elegooofficial/neptune3plus/BOM/Neptune 3 Plus  Bom.xlsx

Neptune 3 Plus Bom
Order | Part Code | Part Name | Specification | UNIT | Qty
1 | 01.003.0011 | 4040 Aluminum profile_Bottom & Right | 40*40-L=486mm,Anodizing | pcs | 1
2 | 01.003.0012 | 4040 Aluminum profile_Bottom & Left | 40*40-L=486mm,Anodizing | pcs | 1
3 | 01.001.0015 | 2020 Aluminum profile_Bottom | 20*20-L=360mm,Anodizing | pcs | 2
4 | 01.002.0008 | 2040 Aluminum profile_Z-axis_Right | 20*40-L=558mm Anodizing+silk | pcs | 1
5 | 01.002.0009 | 2040 Aluminum profile_Z-axis_Left | 20*40-L=558mm Anodizing+silk | pcs | 1
6 | 01.001.0013 | 2020 Aluminum profile_X-axis | 20*20-L=461mm,Anodizing | pcs | 1
7 | 01.001.0014 | 2020 Aluminum profile_Top | 20*20-L=440mm,Anodizing | pcs | 1
8 | 01.002.0010 | 2040 Aluminum profile_Y-axis | 20*40-L=496mm,Anodizing | pcs | 2
9 | 01.006.0001 | φ18 Aluminum profile_Pull rod | φ18*L=548mm,Anodizing | pcs | 2
10 | 02.002.0046 | Cover Plate_Bottom | SPCC T=0.8mm，Spraying,Black | pcs | 1
11 | 02.002.0047 | Cover Plate_Top | SPCC T=1.0mm，Spraying,Black | pcs | 1
12 | 02.002.0048 | Cover Plate_Y-axis | SPCC T=1.0mm，Spraying,Black | pcs | 1
13 | 02.001.0017 | Fixing Plate_Top Bearing_Right | AL5052 T=3.0mm，Spraying,Black | pcs | 1
14 | 02.001.0018 | Fixing Plate_Top Bearing_Left | AL5052 T=3.0mm，Spraying,Black | pcs | 1
15 | 02.002.0049 | Fixing Plate_Y-Belt | SPCC T=1.5mm，Spraying,Black | pcs | 1
16 | 02.001.0019 | Bottom Slider Plate | AL5052 T=4.0mm，Spraying,Black | pcs | 1
17 | 02.002.0030 | Attraction Plate_Magnet | SECC T=1.5mm | pcs | 1
18 | 02.002.0035 | Fixing Plate_Z nut-Left | SPCC T=2.5mm，Spraying,Black | pcs | 1
19 | 02.002.0036 | Fixing Plate_X-axis-stepper | SPCC T=2.5mm，Spraying,Black | pcs | 1
20 | 02.002.0037 | Fixing Plate_Z nut-Right | SPCC T=2.5mm，Spraying,Black | pcs | 1
21 | 02.002.0038 | Driven Plate_Z-axis | SPCC T=2.5mm，Spraying,Black | pcs | 1
22 | 02.002.0039 | Fixing Plate_Extruder | SPCC T=2.5mm，Spraying,Black | pcs | 1
23 | 02.002.0040 | Fixing Plate_Extruder Fan | SPCC T=1.0mm，Spraying,Black | pcs | 1
24 | 02.002.0042 | Fixing Plate_Filament Detector | SPCC T=0.8mm，Spraying,Black | pcs | 1
25 | 02.002.0043 | Fixing Plate_Magnet | SPCC T=0.8mm，Spraying,Black | pcs | 1
26 | 02.002.0044 | Fixing Plate_Extruder Cable | SPCC T=1.0mm，Spraying,Black | pcs | 1
27 | 04.001.0019 | Ground Wire_Power Supply | 18AWG_L350mm_SV1.25-4 terminal+4.8 Plug spring terminal | pcs | 1
28 | 04.001.0020 | Black Silicone Wire | 16AWG Silicone Wire_L340mm_SV1.25-4 terminal+4.8 Plug spring terminal,Black | pcs | 1
29 | 04.001.0021 | Red Silicone Wire | 16AWG Silicone Wire_L340mm_SV1.25-4 terminal+4.8 Plug spring terminal,Red | pcs | 1
30 | 04.014.0003 | Extruder Cable | 26AWG_20Pin,L=2000mm | pcs | 1
31 | 04.003.0006 | Mainboard Wire | 2*1.5²_2Pin_L480mm_SV1.25-4 terminal+E1508 terminal,Red&Black | pcs | 1
32 | 04.005.0019 | Stepper and limit switch wire_Y-axis | 24AWG_6Pin,L1=570mm,L2=610mm,Black | pcs | 1
33 | 04.005.0020 | Stepper wire_Z-axis | 24AWG_2*4Pin,L1=770mm,L2=420mm,Black | pcs | 1
34 | 04.005.0021 | Stepper and limit switch wire_X-axis | 24AWG_6Pin,L1=1400mm,L2=1450mm,Black | pcs | 1
35 | 04.011.0014 | Filament Detector Wire | 26AWG_3Pin,L=820mm,Black | pcs | 1
36 | 04.012.0003 | LED Outgoing wire | 24AWG_2Pin,L=70/76mm,Red&Black | pcs | 1
37 | 04.011.0015 | LED Wire | 24AWG_2Pin,L=850mm,Red&Black | pcs | 1
38 | 04.002.0006 | Heated Bed Wire-I | 13AWG_2Pin Silicone Wire,L=240mm_SV3.5-4U X2terminal | pcs | 1
39 | 04.002.0007 | Heated Bed Wire-II | 13AWG_2Pin Silicone Wire,L=970mm_SV3.5-4U X2terminal | pcs | 1
40 | 04.012.0005 | Signal Wire_Heated Bed | 26AWG_6Pin,L=300mm,Red&Black | pcs | 1
41 | 04.006.0006 | Filament Detector and LED Wire | UL1007 26AWG_5Pin，L1=840mm,L2=580mm,Black | pcs | 1
42 | 04.001.0003 | Red Silicone Wire(Switch) | 16AWG_L90mm_4.8 Plug spring terminal | pcs | 1
43 | 04.011.0009 | Fan Wire | 26AWG_2*2Pin terminal,L=60mm,Red&Black | pcs | 1
44 | 05.001.0095 | Belt Adjust Shell_Y-axis | Grey,ABS757 | pcs | 1
45 | 05.001.0096 | Plastic Bottom Cover_Front | Grey,ABS757 | pcs | 1
46 | 05.001.0097 | Adjust nut-D40 | Black,ABS757 | pcs | 2
47 | 05.001.0068 | Display screen Shell_Top | Grey,ABS757 | pcs | 1
48 | 05.001.0069 | Display screen Shell_Bottom | Grey,ABS757 | pcs | 1
49 | 05.001.0070 | Display screen holder | Grey,ABS757 | pcs | 1
50 | 05.001.0071 | Stepper holder_Z-axis | Grey,ABS757 | pcs | 2
51 | 05.001.0072 | Limit switch pad_Y-axis | Grey,ABS757 | pcs | 1
52 | 05.001.0074 | Limit switch holder_X-axis | Grey,ABS757 | pcs | 1
53 | 05.001.0075 | Belt Adjust Shell_X-axis | Grey,ABS757 | pcs | 1
54 | 05.001.0076 | Extruder Shell | Grey,PC,Fireproof materials_Fire rating V-0 | pcs | 1
55 | 05.001.0077 | Fan holder_Extruder | Grey,PC,Fireproof materials_Fire rating V-0 | pcs | 1
56 | 05.001.0078 | Extruder Handle | Grey,PC,Fireproof materials_Fire rating V-0 | pcs | 1
57 | 05.001.0080 | Gearbox_Bottom | Grey,PC,Fireproof materials_Fire rating V-0 | pcs | 1
58 | 05.001.0081 | Gearbox_Top | Grey,PC,Fireproof materials_Fire rating V-0 | pcs | 1
59 | 05.001.0082 | Cable Snap | Grey,ABS757 | pcs | 2
60 | 05.001.0084 | Filament holder | Grey,ABS757 | pcs | 1
61 | 05.001.0085 | Filament Detector Shell_Top | Grey,ABS757 | pcs | 1
62 | 05.001.0086 | Filament Detector Shell_Bottom | Grey,ABS757 | pcs | 1
63 | 05.001.0087 | Bearing holder_Filament Detector | Grey,ABS757 | pcs | 1
64 | 03.001.0005 | Decelerate Gear | Black POM+45# steel | pcs | 1
65 | 05.001.0088 | Heated Bed Wire holder | Grey,PC,Fireproof materials_Fire rating V-0 | pcs | 1
66 | 05.001.0089 | Filament Detector holder | Grey,ABS757 | pcs | 1
67 | 05.001.0090 | Belt Adjust Bearing holder | Grey,ABS757 | pcs | 2
68 | 05.001.0091 | Belt Adjust nut-D20 | Grey,ABS757 | pcs | 2
69 | 05.001.0092 | Filament Tube | Grey,ABS757 | pcs | 1
70 | 05.001.0020 | Silicone Cover_Heating Block | Silicone,Black | pcs | 1
71 | 05.001.0018 | Adjust nut-D50 | Black,ABS757 | pcs | 4
72 | 07.004.0003 | Heated Bed Platform | 24V,330*330*3mm,420W | pcs | 1
73 | 07.001.0005 | Power Supply | 500W,24V 21A H:40.5m,Black | pcs | 1
74 | 08.001.0018 | MOS Module_Heated Bed | MOS Module_Heated Bed,Max 25A | pcs | 1
75 | 07.008.0004 | LED PCBA | LED PCBA,INPUT 24v,3.8w,L350mm | pcs | 1
76 | 07.002.0009 | Stepper_Y-axis | Stepper42-40,Black | pcs | 1
77 | 08.001.0016 | Mainboard | ZNP Robin Nano_DW V2.2 | pcs | 1
78 | 08.002.0006 | Display Screen | 4.3inch Capacitive touch Display screen | pcs | 1
79 | 04.011.0012 | RJ11 Wire | RJ11 Spring Wire,1.5m,Single core:7x0.08,Black | pcs | 1
80 | 04.011.0013 | Display Screen Wire_Inside | RJ11,4P4C,4Pin XH2.54 terminal | pcs | 1
81 | 07.003.0004 | limit switch _X-axis | limit switch,14x45x1.6mm,Red | SET | 1
82 | 07.003.0021 | limit switch _Y-axis | Limit switch,20x20x1.6mm,Red | pcs | 1
83 | 08.006.0003 | Filament Detector Sensor | H22B1 PCBA module | pcs | 1
84 | 08.001.0017 | Extruder PCBA | EL-A-V2.1.1.400,42x41x1.6mm Fiber glass board,Red | pcs | 1
85 | 07.002.0004 | Stepper_X-axis | Model:42HD2037-02,Two-phase,34mm,Black | SET | 1
86 | 07.002.0005 | Stepper_Z-axis | Model:42HD2037-04,Two-phase,34mm,Black | SET | 2
87 | 07.002.0008 | Stepper_Extruder | Model:42HD1418-01,Two-phase,25mm | SET | 1
88 | 07.003.0019 | Combination Switch | Three-in-one combination switch | pcs | 1
89 | 08.003.0001 | Power Fuse | 10A 250V 5*20 | pcs | 1
90 | 07.007.0004 | Heating Tube | 24V，40W,Φ6*20,L70mm 2Pin XH2.54 terminal | pcs | 1
91 | 07.005.0009 | 6010 Fan | 6010 Fan,24V,3000r/min | pcs | 1
92 | 07.005.0010 | 4010 Turbo Fan | 4010 Turbo Fan,24V,7000r/min | pcs | 2
93 | 07.005.0011 | 4015 Turbo Fan | 4015 Turbo Fan,24V,7000r/min | pcs | 1
94 | 07.003.0020 | Level Sensor | Model:NPN N3F-H4NB Inductive proximity Sensor | pcs | 1
95 | 07.006.0007 | Thermistor_Nozzle | NTC100K D1.8-L100mm,2Pin XH2.0 terminal | pcs | 1
96 | 07.006.0006 | Thermistor_Heated Bed | NTC100K D1.8-L1500mm,2Pin XH2.54 terminal | pcs | 1
97 | 03.002.0002 | Heated Blcok | AL6061,20*20*10mm， | pcs | 1
98 | 03.003.0005 | Heat Dissipation Block | AL6061,42*20.5*20.5mm | pcs | 1
99 | 03.004.0001 | Nozzle | Brass M6，0.4mm | pcs | 3
100 | 03.005.0003 | Throat Tube | Ti alloy,CT4，D7-M6-L27mm | pcs | 1
101 | 20.001.0001 | V-slot Wheel kit | 1*Black POM Wheel+2*625ZZBearing+1*M5 Flat Washer_V-slot Wheel | pcs | 16
102 | 03.006.0001 | Metal Eccentric Spacer | D7.2-d5-H-8.35mm,Hexagon | pcs | 8
103 | 03.006.0004 | Metal Spacer-II | D8-d5-H-2.0m,Circular |  | 6
104 | 03.006.0002 | Metal Spacer_H8.35 | D8-d5-H-8.35mm,Circular | pcs | 14
105 | 03.001.0002 | Extrusion Gear 1 | SUS304,0.5M,17T,13.8*9.3mm,M3 threaded hole | pcs | 1
106 | 03.001.0003 | Extrusion Gear 2 | SUS304,0.5M,17T,13.8*9.3mm | pcs | 1
107 | 03.001.0004 | Extruder Stepper Gear | Brass,0.5M,17T,H4.5mm | pcs | 1
108 | 06.003.0002 | Lead screws nut_T8 | T8-8 | pcs | 2
109 | 06.003.0008 | Lead screws_T8 | Lead screws_T8*8-L=522mm | pcs | 2
110 | 10.008.0016 | PEI Platform | PEI spray,330mm*340mm | pcs | 1
111 | 10.008.0017 | Soft Magnetic Platform | 330*330*1.5mm,Adhesive backing,Black | pcs | 1
112 | 05.002.0004 | 2GT Timing Belt_Close | 2GT-W6 PL840mm | pcs | 1
113 | 11.008.0008 | Cover Strip_Aluminum profile-I | W6-L470mm,Black | pcs | 1
114 | 11.008.0009 | Cover Strip_Aluminum profile-II | W6-L100mm,Black | pcs | 1
115 | 10.001.0014 | Nylon braided sleeve_W16 | W16-L710mm | pcs | 2
116 | 09.012.0002 | M3 Hex Standoff Brass Spacer | M3x27+6 Hex Standoff Brass Spacer | pcs | 2
117 | 10.001.0009 | Nylon braided sleeve_W8 | W8-L600mm | pcs | 1
118 | 06.008.0001 | Axis_Detector Bearing_L10 | SUS304,φ3,L10mm | pcs | 1
119 | 06.008.0002 | Axis_Extrusion Gear_L19 | SUS304,φ3,L19mm | pcs | 1
120 | 06.008.0003 | Axis_Extrusion Gear holder_L27 | SUS304,φ3,L27mm | pcs | 1
121 | 06.004.0010 | Spring_Extrusion | φ1.0mm*φ8mm*L20mm | pcs | 1
122 | 06.004.0009 | Spring_Filament Detector | φ0.4mm*φ6mm*L15mm | pcs | 1
123 | 06.001.0009 | MR85zz Bearing | MR85zz | pcs | 2
124 | 06.001.0004 | Needle Bearing | OD:5.0mm,ID:3,0mm,H:7mm SUS Needle | pcs | 2
125 | 06.001.0010 | MF148zz Flange Bearing | MF148zz | pcs | 2
126 | 06.001.0002 | F624zz Bearing | F624zz | pcs | 4
127 | 06.001.0007 | 624zz V Bearing | 624 V | pcs | 1
128 | 06.001.0011 | MR93ZZ Bearing | MR93ZZ | pcs | 1
129 | 06.007.0001 | Rigid Coupling | D5*8 | pcs | 2
130 | 06.006.0001 | Timing Pulley_ID 5 | 2GT_d5mm_20teeth_W6mm,Black | pcs | 2
131 | 06.006.0002 | Timing Pulley_ID 8 | 2GT_d8mm_20teeth_W6mm,Black | pcs | 2
132 | 05.002.0007 | 2GT Timing Belt_Open | 2GT-W6 X-axis-L790mm,Y-axis-L750mm,Black,100m/roll | m | 1.915
133 | 06.009.0002 | Copper Sleeve_Timing Belt | D7mm_0.5mm | pcs | 4
134 | 03.006.0005 | Heated Bed Spacer | Material:SUS304,OD:7.0mm,ID:6.0mm,H:13.5mm | pcs | 2
135 | 06.009.0027 | Display Screen Magnet | NdFeB strong magnet,50*30*4mm,2000GS | pcs | 1
136 | 11.008.0003 | PET Plastic Sheet | Material:PET,37.5*64mm,Thickness:0.2mm,Adhesive backing,Black | pcs | 1
137 | 10.005.0004 | Rubber Mat | Material:rubber,38*20*20mm,Black | pcs | 4
138 | 05.007.0006 | PTFE Tube | Material:PTFE,OD4.0mm,ID2.0mm,L54mm,Light blue | m | 0.108
139 | 10.008.0015 | Fixing Clamp_Extruder Cable | Model:UC-2,ID:10.4mm,Black | pcs | 1
140 | 05.008.0001 | Cable Tie holder | Model:STM-1S,Black,W6.9-L12.6mm | pcs | 3
141 | 05.001.0094 | Wire Protective Ring | Model:SB20,Protective Ring,Black | pcs | 1
142 | 10.007.0004 | Cable Tie 4-150 | Nylon,Black_4-150mm | pcs | 20
143 | 11.001.0001 | High Temp Resistant Thread Sealant | High Temp Resistant Thread Sealant | m | 0.014
144 | 11.003.0001 | Insulation Cotton | Insulation Cotton,50*60mm | pcs | 1
145 | 11.004.0001 | Grease | Transparent_Paste | pcs | 2
146 | 11.004.0002 | Thermal Grease | Grey | g | 0.2
147 | 11.006.0001 | Solder Wire | φ2mm ,500g/roll,lead free | g | 0.5
148 | 11.002.0005 | Acetate Cloth Tape | W40mm，30m,Black,Acetate Cloth Tape | m | 0.2
149 | 11.002.0004 | Packing Tape | W50mm，100m | m | 0.5
150 | 11.009.0002 | Heat Shrinkable Tube_ID5 | φ5.0mm*20mm，ID:3.0mm，Black | pcs | 1
151 | 11.009.0001 | Heat Shrinkable Tube_ID2.5 | φ2.5mm*20mm，ID:3.0mm，Black | pcs | 2
152 | 11.008.0007 | Electronic glue | Model:FST5980 RTV silica gel,Black,100ml/piece | pcs | 1
153 | 11.001.0002 | 480 Quick-drying Adhesive | Model:480,Quick-drying Adhesive,Black,20g/piece | g | 0.4
154 | 06.004.0011 | Spring_Platform | φ7*1*18mm | pcs | 6
155 | 10.004.0001 | TF Memory Card | 8G | pcs | 1
156 | 10.004.0002 | TF Memory Card Reader | CHUANYU（Common） | pcs | 1
157 | 04.008.0001 | Power Supply Wire | Length:1.5M_Wire diameter:6.5mm_Rated power:2500W_Rated voltage:250V_Pure copper_3*0.75mm²_Plug:nickel-plated brass_Flame-Retardant PVC | pcs | 1
158 | 04.009.0001 | USB Cable | Bluish transparent_Type-A to Type-B_Length:53cm_Wire diameter:4.8mm | pcs | 1
159 | 10.008.0012 | Needle | Stainless Steel_L70mm_d0.35mm | pcs | 1
160 | 10.002.0015 | Plastic Scraper | Material:PP,Plastic Scraper,yellow | pcs | 1
161 | 10.002.0002 | Nippers | Cutting Nippers | pcs | 1
162 | 10.002.0003 | 1.5mm Inner Hexagon Spanner | Carbon Steel_1.5mm_Nickel-plated | pcs | 1
163 | 10.002.0004 | 2.0mm Inner Hexagon Spanner | Carbon Steel_2.0mm_Nickel-plated | pcs | 1
164 | 10.002.0005 | 2.5mm Inner Hexagon Spanner | Carbon Steel_2.5mm_Nickel-plated | pcs | 1
165 | 10.002.0006 | 3.0mm Inner Hexagon Spanner | Carbon Steel_3.0mm_Nickel-plated | pcs | 1
166 | 10.002.0007 | 4.0mm Inner Hexagon Spanner | Carbon Steel_4.0mm_Nickel-plated | pcs | 1
167 | 10.002.0008 | Flat Blade screwdriver | 2.5mm_Flat Blade | pcs | 1
168 | 10.002.0009 | Cruciform screwdriver | 4.0mm_ Cruciform | pcs | 1
169 | 10.002.0010 | Double Open Spanner | 45#steel_8-10#_Galvanized | pcs | 1
170 | 10.002.0011 | Open Spanner | 45#steel_6#_Galvanized | pcs | 1
171 | 12.002.0001 | Self Sealing Bag Ⅰ | 18cm*26cm_Thickness:0.06mm | pcs | 1
172 | 12.002.0003 | Self Sealing Bag Ⅱ | 9cm*13cm_Thickness:0.08mm | pcs | 3
173 | 12.002.0004 | Self Sealing Bag Ⅲ | 6cm*9cm_Thickness:0.08mm | pcs | 6
174 | 13.001.0001 | Filament | L5m_Random color | pcs | 1
175 | 10.003.0001 | Product Certificate | Triangle | pcs | 1
176 | 12.003.0025 | Neptune 3 Pro Foam |  | pcs | 1
177 | 12.001.0027 | Neptune 3 Pro Carton |  | pcs | 1
178 | 10.003.0024 | Neptune 3 Pro Manufacturing Number Sticker | 210*120mm | pcs | 1
179 | 12.004.0018 | Neptune 3 Pro Machine Specification Sticker | 70*38mm | pcs | 1
180 | 10.007.0003 | Plastic Twist Tie | White_Plastic Twist Tie_0.55mm*80mm | pcs | 1
181 | 10.003.0025 | Neptune 3 Pro User Guide | 128G_Coated Paper,4color printing | pcs | 1
182 | 12.005.0016 | Display Screen Warning label | 49*26mm,80G_Coated Paper | pcs | 1
183 | 12.005.0018 | Stepper Warning label | 14*13mm,Triangle,80G_Coated Paper | pcs | 1
184 | 11.005.0010 | PE Stretch film | PE Stretch film,W75cm,L280m | m | 0.6
185 | 11.001.0004 | Solid gule-PVP | Material:PVP, high viscosity, formaldehyde free, 20g/piece | pcs | 1
186 | 09.013.0002 | Eye bolt M5x25 | Stainless Steel_M5x25 | pcs | 4
187 | 09.001.0018 | Hexagon Socket Countersunk Head screw_M2x5 | Carbon Steel_M2x5 | pcs | 3
188 | 09.001.0002 | Hexagon Socket Countersunk Head screw_M3x10 | Stainless Steel_M3x10 | pcs | 3
189 | 09.001.0011 | Hexagon Socket Countersunk Head screw_M3x6 | Stainless Steel_M3x6 | pcs | 7
190 | 09.001.0014 | Hexagon Socket Countersunk Head screw_M3x35 | Stainless Steel_M3x35 | pcs | 3
191 | 09.001.0015 | Hexagon Socket Countersunk Head screw_M4x20 | Stainless Steel_M4x20 | pcs | 6
192 | 09.001.0016 | Hexagon Socket Countersunk Head screw_M4x30 | Stainless Steel_M4x30 | pcs | 6
193 | 09.002.0017 | Hexagon Socket Button Head screw_M4x4 | Stainless Steel_M4x4 | pcs | 5
194 | 09.002.0031 | Hexagon Socket Button Head screw_M3x6 | Carbon Steel_M3x6 | pcs | 10
195 | 09.002.0001 | Hexagon Socket Button Head screw_M3x6 | Stainless Steel_M3x6 | pcs | 20
196 | 09.002.0002 | Hexagon Socket Button Head screw_M3x16 | Stainless Steel_M3x16 | pcs | 3
197 | 09.002.0028 | Hexagon Socket Button Head screw_M5x32 | Stainless Steel_M5x32 | pcs | 6
198 | 09.002.0003 | Hexagon Socket Button Head screw_M5x30 | Stainless Steel_M5x30 | pcs | 4
199 | 09.002.0005 | Hexagon Socket Button Head screw_M5x40 | Stainless Steel_M5x40 | pcs | 6
200 | 09.002.0006 | Hexagon Socket Button Head screw_M5x8 | Stainless Steel_M5x8 | pcs | 10
201 | 09.007.0002 | Hexagon Socket Button Head Combination screw_M4x18 | Carbon Steel_M4x18 | pcs | 4
202 | 09.002.0029 | Hexagon Socket Button Head screw_M4x18 | Stainless Steel_M4x18 | pcs | 2
203 | 09.002.0009 | Hexagon Socket Button Head screw_M3x12 | Stainless Steel_M3x12 | pcs | 43
204 | 09.002.0012 | Hexagon Socket Button Head screw_M3x8 | Stainless Steel_M3x8 | pcs | 3
205 | 09.002.0015 | Hexagon Socket Button Head screw_M5x18 | Stainless Steel_M5x18 | pcs | 2
206 | 09.002.0016 | Hexagon Socket Button Head screw_M3x4 | Stainless Steel_M3x4 | pcs | 6
207 | 09.002.0020 | Hexagon Socket Button Head screw_M4x20 | Stainless Steel_M4x20 | pcs | 5
208 | 09.002.0027 | Hexagon Socket Button Head screw_M4x25 | Stainless Steel_M4x25 | pcs | 1
209 | 09.002.0022 | Hexagon Socket Button Head screw_M3x30 | Stainless Steel_M3x30 | pcs | 1
210 | 09.002.0024 | Hexagon Socket Button Head screw_M5x25 | Stainless Steel_M5x25 | pcs | 4
211 | 09.002.0018 | Hexagon Socket Button Head screw_M4x8 | Stainless Steel_M4x8 | pcs | 3
212 | 09.002.0025 | Hexagon Socket Button Head screw_M4x10 | Stainless Steel_M4x10 | pcs | 2
213 | 09.002.0023 | Hexagon Socket Button Head Combination screw_M4x20 | Stainless Steel_M4x20 | pcs | 8
214 | 09.003.0017 | Hexagon Socket Head Cap screw_M2X10 | Stainless Steel_M2X10 | pcs | 2
215 | 09.003.0013 | Hexagon Socket Head Cap screw_M3X20 | Stainless Steel_M3X20 | pcs | 2
216 | 09.003.0016 | Hexagon Socket Head Cap screw Step screw_4x3xM3 | Stainless Steel_4x3xM3 | pcs | 1
217 | 09.005.0013 | Square nut_M4 | Carbon Steel_M4 | pcs | 1
218 | 09.003.0015 | Hexagon Socket Head Cap screw_Thin head_M4x12 | Stainless Steel_M4x12 | pcs | 1
219 | 09.004.0002 | Spring Washer_M3 | Stainless Steel_M3 | pcs | 4
220 | 09.004.0004 | Spring Washer_M4 | Stainless Steel_M4 | pcs | 1
221 | 09.004.0003 | Flat Washer_M5 | Stainless Steel_M5 | pcs | 8
222 | 09.005.0005 | Square Profile nut_M4 | Stainless Steel_M4 | pcs | 2
223 | 09.005.0002 | Self-locking nut_M5 | Stainless Steel_M5 | pcs | 16
224 | 09.005.0012 | Self-locking nut_M3 | Stainless Steel_M3 | pcs | 4
225 | 09.005.0014 | Flange nut_M5 | Stainless Steel_M5 | pcs | 4
226 | 09.009.0005 | Cruciform Socket Button Head screw_PWM M2*10 | Carbon Steel_PWM M2*10 | pcs | 3
227 | 09.006.0011 | Cruciform Socket Button Head Tapping screws_Point Tail_PA 2x6 | Carbon Steel_PA 2x6 | pcs | 6
228 | 09.006.0003 | Cruciform Socket Button Head Tapping screws_Point Tail_PA3x8 | Carbon Steel_PA3x8 | pcs | 8
229 | 09.006.0012 | Cruciform Socket Button Head Tapping screws_Flat tail_KT 5x10 | Carbon Steel_KT 5x10 | pcs | 4
230 | 09.007.0001 | Combination screw_M3x4 | Stainless Steel_M3x4 | pcs | 1
231 | 09.007.0004 | Hexagon Socket Head Cap Combination screw_M5X45 | Carbon Steel_M5X45 | pcs | 8
232 | 09.007.0005 | Hexagon Socket Head Cap Combination screw_M5X30 | Carbon Steel_M5X30 | pcs | 8
233 | 09.008.0001 | Set screw_M3x3 | Carbon Steel_M3x3 | pcs | 2
234 | 09.008.0008 | Butt nut_M4x16 | Stainless Steel_M4x16 | pcs | 2
235 | 09.008.0010 | Butt screw_M4 | Stainless Steel_M4 | pcs | 2
236 | 09.004.0010 | Enlarged flat washer M5 | Stainless Steel_M5xφ18x1 | pcs | 2
