elegooofficial/neptune3plus/PCBA/LCD/BOM-4.3inch Display screen(1).xls

4.3inch Capacitive Touch Display Screen BOM
Items | Tag No | Part Name | Specification | UNIT | Qty
1 |  | 4.3寸_EWV_Module | HX043015CNR-40-10N | Pcs | 1
2 |  | TP_4.3inch CAP TP Cover | 117.8*77.8*1.6MM，Silk:Black | Pcs | 1
3 |  | Buzzer Passive 9*5.5mm 3.3V/5.5Ω Plug-in | Buzzer Passive 9*5.5mm 3.3V/5.5Ω Plug-In | Pcs | 1
4 |  | 4.3/5.0 inchmm Electrostatic bag | 110*170 | Pcs | 1
5 |  | Conductive Sponge,adhesive backing | 10*10*2.8MM | Pcs | 1
6 |  | Foam Box(NX120) | Outside dim:510*315*205mm;Internal dim：135*15*85 mm | Pcs | 1
7 |  | High temperature tape | W20mm,T0.08mm,L33mm | Pcs | 1
8 |  | Double-faced adhesive | 80*6.0*1.0mm（3M 9448A） | Pcs | 2
9 | R40 | Resistor | RES-TFC 1.5R--OHM ±5% 1/16W 0603 | Pcs | 1
10 | R23 | Resistor | RES-TFC 5.1R--OHM ±5% 1/16W 0603 | Pcs | 1
11 | R11,R30 | Resistor | RES-TFC 33R--OHM ±5% 1/16W 0603 | Pcs | 2
12 | R7, R8, R10,R12, R21, R29, R37,R41 | Resistor | RES-TFC 10K--OHM ±5% 1/16W 0603 | Pcs | 8
13 | R34,R33 | Resistor | RES-TFC 20K--OHM ±5% 1/16W 0603 | Pcs | 2
14 | R25 | Resistor | RES-TFC 30K--OHM ±5% 1/16W 0603 | Pcs | 1
15 | R24 | Resistor | RES-TFC 47K--OHM ±5% 1/16W 0603 | Pcs | 1
16 | R3,R42,R36,R39,R45, | Resistor | RES-TFC 1K-OHM ±1% 1/16W 0603 | Pcs | 5
17 | R22 | Resistor | RES-TFC 4.99K-OHM ±1% 1/16W 0603 | Pcs | 1
18 | R18,R19,R46 | Resistor | RES-TFC 4.42K--OHM ±1% 1/16W 0603 | Pcs | 3
19 | C8 | Resistor | RES-TFC 220R--OHM ±5% 1/8W 0805 | Pcs | 1
20 | RN5 | Resistor | Network Resisto RES-TFC 10K--OHM ±5% 1/16W 1206-8P4R | Pcs | 1
21 | RN1 | Resistor | Network Resisto RES-TFC 33R--OHM ±5% 1/16W 1206-8P4R | Pcs | 1
22 | B2,B3 | Resistor | RES-TFC 0R-OHM ±5% 1/4W 1206 | Pcs | 2
23 | C15 | Capacitor | CAP-CCC 0.01uF +80-20% 50V Y5V 0603 | Pcs | 1
24 | C36,C38 | Capacitor | CAP-CCC 2.2uF +80-20% 25V Y5V 0603 | Pcs | 2
25 | C2,C28 | Capacitor | CAP-CCC 1uF +80-20% 50V Y5V 0603 | Pcs | 2
26 | C56 | Capacitor | CAP-CCC 470-pF +80-20% 50V Y5V 0603 | Pcs | 1
27 | C29,C45,C65 | Capacitor | CAP-CCC 22--uF +80-20% 10V SMT 0805 | Pcs | 3
28 | C1,C3,C7,C10, C11,C12,C13,C16,C18,C26, C27,C32,C33,C35,C37,C42, C46,C59 | Capacitor | CAP-CCC 0.1--uF +80-20% 50V Y5V 0402 | Pcs | 18
29 | C14 | Capacitor | CL05A105KO5NNNC 1uF ±10% 16V X5R 0402 | Pcs | 1
30 | C17,C34 | Capacitor | CAP-CCC 10uF +80-20% 35V 1206 | Pcs | 2
31 | D2 | Diode | 1N5819 SS14 SMA_ DO-214 COMON（SS14 SMA MDD) | Pcs | 1
32 | D4 | Diode | SMBJ6.0CA SMB(DO-214AA) 双向 MDD | Pcs | 1
33 | ZD1 | Diode | 5.1V 0805（BZT52C5V1S SOD-323 MDD） | Pcs | 1
34 | D1 | Diode | SD103AWS SOD323 0805 | Pcs | 1
35 | ED5,ED10 | Diode | ESD ESD3B5CM SOD-323 MDD | Pcs | 2
36 | Q5 | Diode | NPN S8050 SOT-23 MDD | Pcs | 1
37 | Q2 | Diode | MOS AO3401 SOT-23 | Pcs | 1
38 | L4 | Inductance | BWPA3015S4R7MT | Pcs | 1
39 | L1 | Inductance | 10uh BWPA3015S100MT | Pcs | 1
40 | B4 | Inductance | CBG160808U330T 0603 | Pcs | 1
41 | B1 | Inductance | PZ2012D601-R80TF 0805 | Pcs | 1
42 | U4 | Voltage Stabilizing IC | AP3019AKTR-G1 SOT-23-6 | Pcs | 1
43 | U7 | Voltage Stabilizing IC | RY3408 SOT-23-5 | Pcs | 1
44 | U1 | IC | AIHMI-T7 QFN80 9*9 V1 | Pcs | 1
45 | U3 | IC | (X2) ZB25VQ128ASIG SOP-8 | Pcs | 1
46 | CON1 | Connector | FPC Connector,0.5MM 40P Top drawer type | Pcs | 1
47 | J3 | Connector | XH Connector,2.54MM XH-4P Horizonta SMT Connector | Pcs | 1
48 | SD1 | Connector | TFConnector,Self ejection | Pcs | 1
49 | CON2 | Connector | FPC Connector 0.5MM 6P H1.0 Insert front and press backward | Pcs | 1
50 | PCB | PCB-TJC4827X243_011_Z05-V1.1 | PCB-TJC4827X243_011_Z05-V1.1 | Pcs | 1
