elegooofficial/neptune3plus/PCBA/Limit Switch/X-axis limit bom.xls

Items | Part name | Packag description | Qty | bit number
1 | Micro switch | W12.7xD5.7xH6.6 Micro switch 0.5A 125V straight hilt:13.5MM,clubfoot right,Fireproof material | 1 | J1
2 | Connector | XH2.54-3AW，90 degree connector，Fireproof material | 1 | J2
3 | Pcb | 45*14mm，FR-4，2_layer，1.6mm，red Soldermask and white silkscreen ， HAL lead free technology ，Through hole and oil，Thickness of copper sheet:1oz，version：EL-A-V3.3.3.100 | 1
4 | Screw | Cross recessed pan head tapping screws SUS_304 M1.7*8 | 2
