elegooofficial/neptune3plus/PCBA/Mainboard/MAINBOAED BOM.xls

MAINBOARD BOM
Items | Tag No. | Part Name | Specification | UNIT | Qty
1 |  | PCB ZNP Robin Nano_DW V2.2_001（ELEGOO） | PCB 110*84*1.6 Red | PCS | 1
2 | C1, C2, C3, C4, C5, C7, C10, C11, C12, C15, C16, C19, C26, C27, C28, C29, C31, C32, C34, C35, C36, C37, C38, C39, C40, C42, C43, C46, C49, C50, C52, C56, C58, C59, C60, C63, C65, C67, C68, C70, C71 | Capacitor | C0603,100nF | PCS | 41
3 | C13, C45, C51, C61 | Capacitor | C0603,22nF | PCS | 4
4 | C47, C48, C53, C66 | Capacitor | C0603,220nF | PCS | 4
5 | C8, C9 | Capacitor | C0603,22pF | PCS | 2
6 | C54, C69 | Capacitor | C0603,100pF | PCS | 2
7 | C6 | Capacitor | C0603,2.2uF | PCS | 1
8 | C62, C64 | Capacitor | C0603,47pF | PCS | 2
9 | C20 | Capacitor | C0603,150pF | PCS | 1
10 | C30 | Capacitor | C0603,4.7uF | PCS | 1
11 | C21, C22 | Capacitor | C0805,10uF | PCS | 2
12 | C23, C24, C25 | Aluminium electrolytic capacitor | 10uF,SMD-4x5.4mm | PCS | 3
13 | C14, C18, C41, C44, C55, C57, C72 | Aluminium electrolytic capacitor | 100uF,SMD-6.3x7.7mm | PCS | 7
14 | C17 | Aluminium electrolytic capacitor | 220uF,SMD-6.3x7.7mm | PCS | 1
15 | R16, R18, R20, R22, R53, R55, R56, R82, R87, R89, R91, R93, R134, R135, R136, R137, R138, R139, R140, R141, R142, R143, R144, R145, R146, R147, R148 | Resistor | R0603,100Ω | PCS | 27
16 | R73, R74, R75, R76, R77, R78, R79, R80, R103, R104, R105, R106, R116, R117, R118, R119, R149, R150, R151, R152 | Resistor | R0603,6.8KΩ | PCS | 20
17 | R5, R6, R15, R17, R19, R21, R23, R24, R25, R26, R37, R38, R49, R51, R57, R122, R130, R131, R132, R133 | Resistor | R0603,4.7KΩ | PCS | 20
18 | R1, R2, R31, R32, R33, R36, R44, R45, R47, R48, R58, R59, R67, R68, R85, R95, R99, R109, R113 | Resistor | R0603,10KΩ | PCS | 19
19 | R7, R9, R12, R14, R54, R70, R72, R86, R88, R90, R92, R101, R102, R115 | Resistor | R0603,100KΩ | PCS | 14
20 | R27, R28, R29, R30, R39, R40, R46, R50, R52, R60 | Resistor | R0603,1KΩ | PCS | 10
21 | R81, R84, R107, R120 | Resistor | R0603,20KΩ | PCS | 4
22 | R61, R62, R64, R66, R96, R98, R110, R112 | Resistor | R0603,0Ω | PCS | 8
23 | R8, R34, R35 | Resistor | R0603,33Ω | PCS | 3
24 | R41, R42 | Resistor | R0603,22Ω | PCS | 2
25 | R4 | Resistor | R0603,1MΩ | PCS | 1
26 | R10 | Resistor | R0603,210KΩ | PCS | 1
27 | R11 | Resistor | R0603,40.2KΩ | PCS | 1
28 | R13 | Resistor | R0603,24.9K | PCS | 1
29 | R63, R65, R69, R71, R97, R100, R111, R114 | Resistor | R0805,0.2Ω | PCS | 8
30 | R43 | Resistor | R0805,10Ω | PCS | 1
31 | R83, R94, R108, R121 | Resistor_Adj | SMT-TC33X-20KΩ-100mW | PCS | 4
32 | L1 | Inductance | SMT-15uH/3A 7*7*4 | PCS | 1
33 | L2 | magnetic bead | L0805,BLM21PG221SN1D | PCS | 1
34 | D3, D30, D31 | Diode | DO-214AC,B340A-13-F | PCS | 3
35 | D1 | Rectifier diode | DO-214AC-SMA-S1G-1A | PCS | 1
36 | D2 | Rectifier diode | SMA-SMA-S1A-1A | PCS | 1
37 | D12 | TVS Diode | SMB(DO-214AA)J28A | PCS | 1
38 | D13 | TVS Diode | SMB(DO-214AA)J5.0A | PCS | 1
39 | D32, D33, D34, D35 | TVS Diode | DFN1006-2,AU0561P1 | PCS | 4
40 | D29 | TVS Diode | DFN1006-2,AU0521P1 | PCS | 1
41 | D5, D6, D7, D8, D9, D22 | LED | LED0603-10mA Red | PCS | 6
42 | D10, D11 | LED | LED0603-10mA Green | PCS | 2
43 | D4 | Rectifier diode | SOD-123 SS14/DS14W | PCS | 1
44 | D14, D15, D16, D17, D18, D19, D20, D21, D26 | Schottky Barrier Diode | SOT-23 BAT54S | PCS | 9
45 | D23, D24, D25, D27, D28, D36, D37 | Schottky Barrier Diode | SOD-323 1N5819WS | PCS | 7
46 | U3, U7, U8, U9 | IC | QFN-28 MS35774 | PCS | 4
47 | U2 | IC | LQFP-64 STM32F401RET6 | PCS | 1
48 | U1 | IC | SOIC-8 M24C32-FMN6TP | PCS | 1
49 | U4 | IC | SOIC-8_EP MP1584EN-LF-Z | PCS | 1
50 | U6 | IC | SOP-16 CH340C | PCS | 1
51 | U5 | IC | SOT-223 NCP1117ST33T3G | PCS | 1
52 | Y1 | crystal | 49S-DIP-2 8M-20pF±20PPM-60Ω | PCS | 1
53 | F1 | Fuse | F1206-3216FF-30A | PCS | 1
54 | F2 | Fuse | F1206-3216FF-15A | PCS | 1
55 | F3 | (Self-) Resettable fuse | F1812-TLC-MSMD150(1.5A/6V) | PCS | 1
56 | F4 | (Self-) Resettable fuse | F0805-TLC-PSMD050(0.5A/6V) | PCS | 1
57 | SD1 | Socket_Micro SD | Socket_Micro SD-gold-plated | PCS | 1
58 | Q1, Q2, Q5 | NMOS | SOT-23 CJ3400 | PCS | 3
59 | Q3 | MOS | TO-252 HY1403D | PCS | 1
60 | Q4 | MOS | TO-252 HYG024N03LR1D | PCS | 1
61 | J28 | Connector | 2.54 M8x1 Black | PCS | 2
62 | J28 | Connector | 2.54 M8x1 Green | PCS | 2
63 | J15 | Connector | 2.54 M3x1 | PCS | 1
64 | J30 | Connector | 2.54 M4x1 | PCS | 1
65 | J1, J27 | Connector | 2.54 M3x2 | PCS | 2
66 | J2, J6, J7 | Screw Connector | 5.00-6P Green Short-Pin（HG129） | PCS | 1
67 | J33 | Socket_RJ11 | RJ11-4P4C 13*10*14.5 Black | PCS | 1
68 | J16 | USB Connector | USB-B_TH | PCS | 1
69 | J3, J5, J8, J9, TB1,J31, J32 | Connector | 2.54-2P White | PCS | 7
70 | TH1 | Connector | 2.54-2P Black | PCS | 1
71 | TH2 | Connector | 2.54-2P Purple | PCS | 1
72 | J18, J19, J21, J22 | Connector | 2.54-3P White | PCS | 4
73 | J11 | Connector | 2.54-3P Red | PCS | 1
74 | J12 | Connector | 2.54-3P Blue | PCS | 1
75 | J13, J14 | Connector | 2.54-3P Green | PCS | 2
76 | J24 | Connector | 2.54-4P Red | PCS | 1
77 | J23 | Connector | 2.54-4P Blue | PCS | 1
78 | J25 | Connector | 2.54-4P Green | PCS | 1
79 | J26 | Connector | 2.54-4P Black | PCS | 1
80 | J29 | Connector | 2.54-4P Purple | PCS | 1
81 | Drive subdivision def all，USB-PWR def OFF | Jumper cap | 2.54 PINHD-2X1 | PCS | 4
82 | Drive IC | Heat sink | 9*9*12mm Black | PCS | 4
