elegooofficial/neptune3plus/(list of files, cad)

Other CAD files:
Wire/Mainboard Wire.DWG
2D/2020 Aluminum profile_Top.DWG
Wire/LED Wire.DWG
2D/Bottom Slider Plate.DWG
Wire/Red Silicone Wire.DWG
2D/Heat Dissipation Block.DWG
Wire/Signal Wire_Heated Bed.DWG
2D/Extrusion Gear 1.DWG
Wire/4015 Turbo Fan.dwg
Wire/Thermistor_Heated Bed.dwg
2D/2040 Aluminum profile_Right.DWG
Wire/Thermistor_Nozzle.dwg
2D/Fixing Plate_Extruder.DWG
Wire/Display Screen Wire_Inside.dwg
2D/Cover Plate_Bottom.DWG
Wire/Stepper and limit switch wire_Y-axis.DWG
2D/4040 Aluminum profile_Bottom & Right.DWG
Wire/Heated Bed Wire-I.DWG
2D/Attraction Plate_Magnet.DWG
Wire/Heated Bed Wire-II.DWG
2D/4040 Aluminum profile_Bottom & Left.DWG
Wire/Filament Detector and LED Wire.dwg
2D/Fixing Plate_Top Bearing_Right.DWG
Wire/4010 Turbo Fan.dwg
2D/Fixing Plate_Extruder Cable.DWG
Wire/Stepper and limit switch wire_X-axis.DWG
2D/Driven Plate_Z-axis.DWG
Wire/Stepper wire_Z-axis.DWG
2D/Fixing Plate_Extruder Fan.DWG
Wire/Extruder Cable.DWG
2D/Fixing Plate_Y-Belt.DWG
Wire/LED Outgoing wire.DWG
2D/Cover Plate_Y-axis.DWG
Wire/Red Silicone Wire(Switch).dwg
Wire/Filament Detector Wire.DWG
2D/2020 Aluminum profile_Bottom.DWG
Wire/Fan Wire.dwg
2D/2040 Aluminum profile_Left.DWG
Wire/Ground Wire_Power Supply.DWG
2D/Fixing Plate_Filament Detector Switch.DWG
2D/Fixing Plate_Top Bearing_Left.DWG
Wire/Heating Tube.dwg
2D/Fixing Plate_Magnet.DWG
Wire/Level Sensor.dwg
2D/Extrusion Gear 2.DWG
Wire/6010 Fan.dwg
Wire/Black Silicone Wire.DWG
2D/2020 Aluminum profile_X-axis.DWG
2D/Fixing Plate_X-axis-stepper.DWG
2D/Heated Blcok.DWG
2D/Fixing Plate_Z nut-Left.DWG
2D/Fixing Plate_Z nut-Right.DWG
