elegooofficial/neptune3plus/2D/2020 Aluminum profile_Bottom.pdf

4

1 | 2 | 3

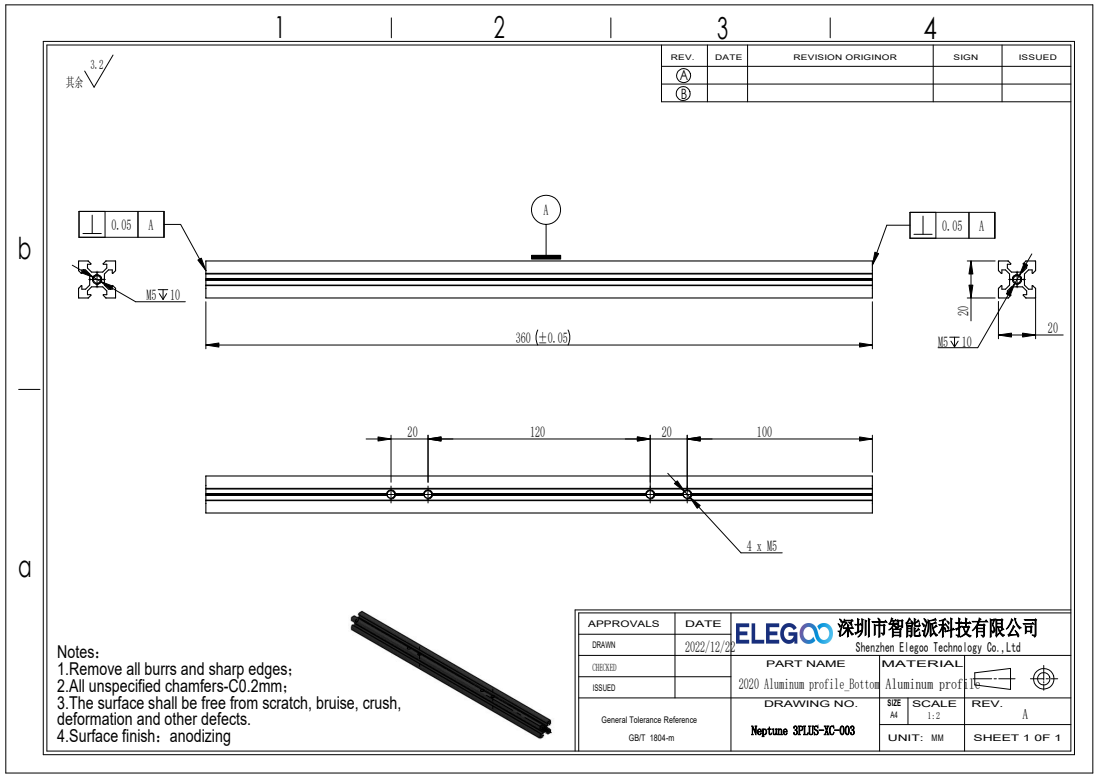
[picture p1: page 1]
Aluminum profile

A | REV. | DATE | REVISION ORIGINOR | SIGN | ISSUED

APPROVALS | DATE | 深圳市智能派科技有限公司 Shenzhen Elegoo Technology Co.,Ltd
DRAWN | 2022/12/22
CHECKED | | PART NAME 2020 Aluminum profile_Bottom | MATERIAL
ISSUED
General Tolerance Reference GB/T 1804-m | DRAWING NO. Neptune 3PLUS-XC-003 | SIZE A4 | SCALE 1:2 | REV. A

Notes：
1.Remove all burrs and sharp edges；
2.All unspecified chamfers-C0.2mm；
3.The surface shall be free from scratch, bruise, crush,
deformation and other defects.
4.Surface finish：anodizing

UNIT: MM | | SHEET 1 0F 1
