elegooofficial/neptune3plus/2D/2040 Aluminum profile_Y-axis.pdf

4

1 | 2 | 3

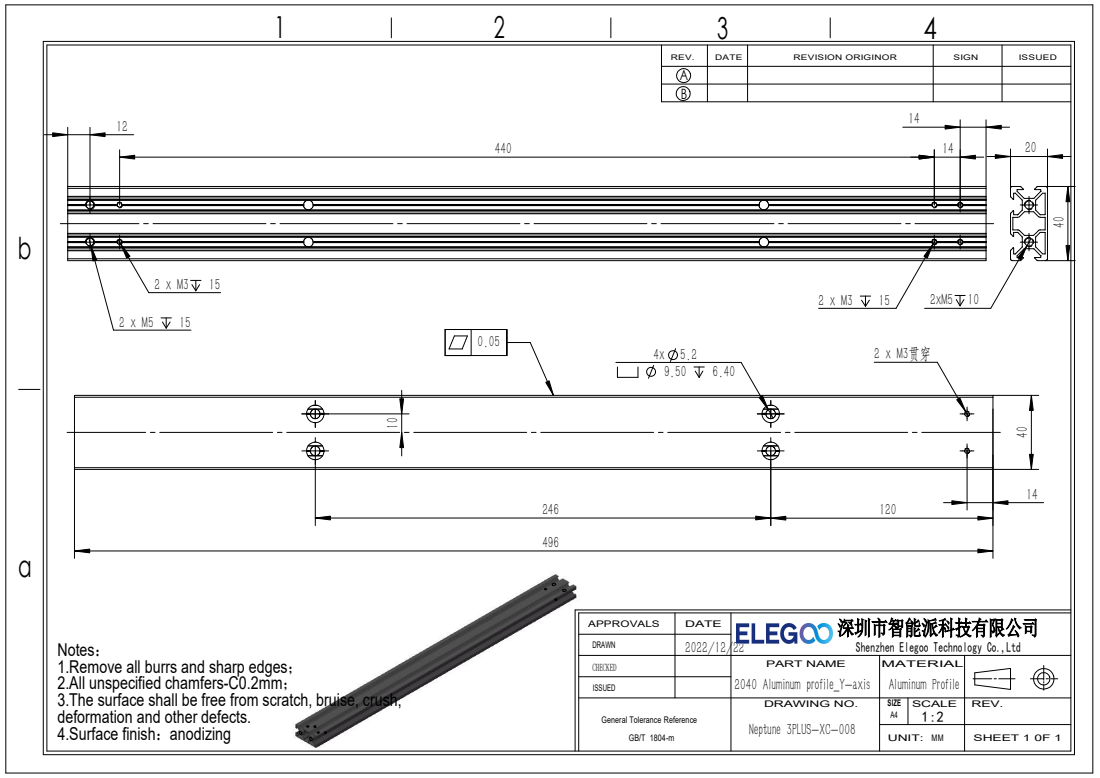
[picture p3: page 1]
2022/12/22 tes：

REV. | DATE | REVISION ORIGINOR | SIGN | ISSUED

APPROVALS | DATE | 深圳市智能派科技有限公司 Shenzhen Elegoo Technology Co.,Ltd
DRAWN
CHECKED | | PART NAME 2040 Aluminum profile_Y-axis | MATERIAL Aluminum Profile
ISSUED
General Tolerance Reference GB/T 1804-m | DRAWING NO. Neptune 3PLUS-XC-008 | SIZE A4 | SCALE 1:2 | REV.

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

UNIT: MM | | SHEET 1 0F 1
