elegooofficial/neptune3plus/2D/4040 Aluminum profile_Bottom & Left.pdf

4

1 | 2 | 3

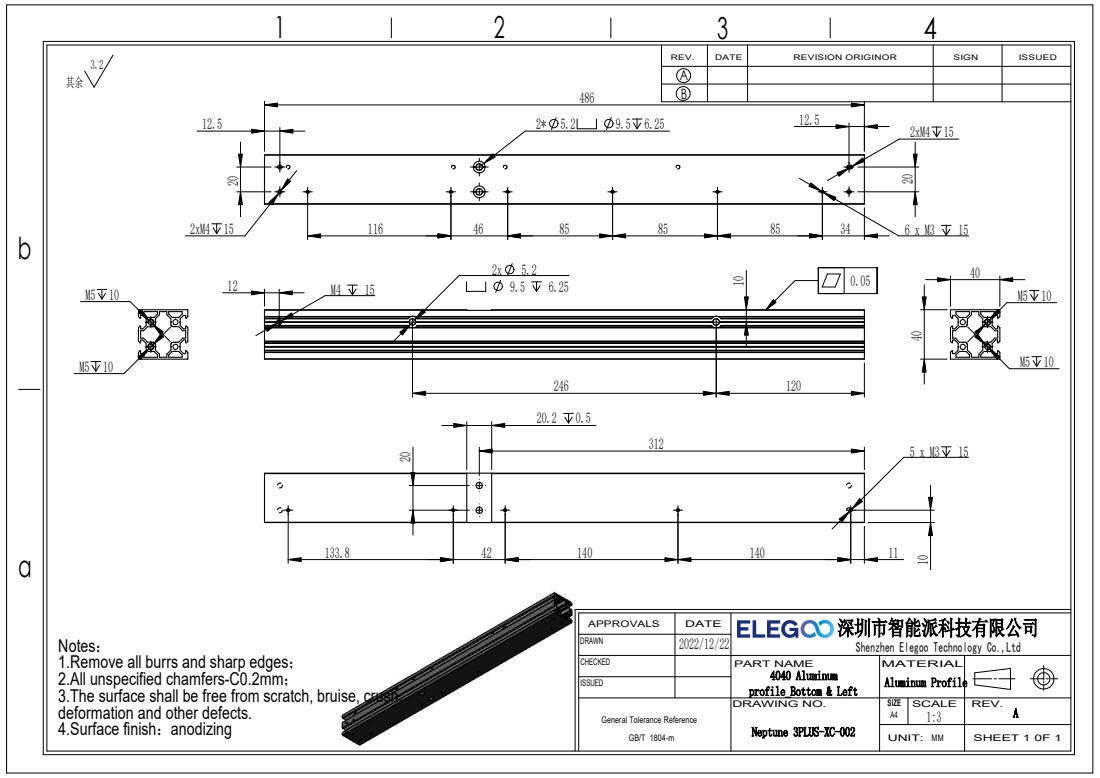
[picture p4: page 1]
4.Surface finish：anodizing; Neptune 3PLUS-XC-002; Aluminum Profile

486 | REV. | DATE | REVISION ORIGINOR | SIGN | ISSUED

APPROVALS | DATE | 深圳市智能派科技有限公司 Shenzhen Elegoo Technology Co.,Ltd
DRAWN | 2022/12/22
CHECKED | | PART NAME 4040 Aluminum profile_Bottom & Left | MATERIAL
ISSUED
General Tolerance Reference GB/T 1804-m | DRAWING NO. | SIZE A4 | SCALE 1:3 | REV. A

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

UNIT: MM | | SHEET 1 0F 1
