elegooofficial/neptune3plus/2D/Attraction Plate_Magnet.pdf

4

1 | 2 | 3

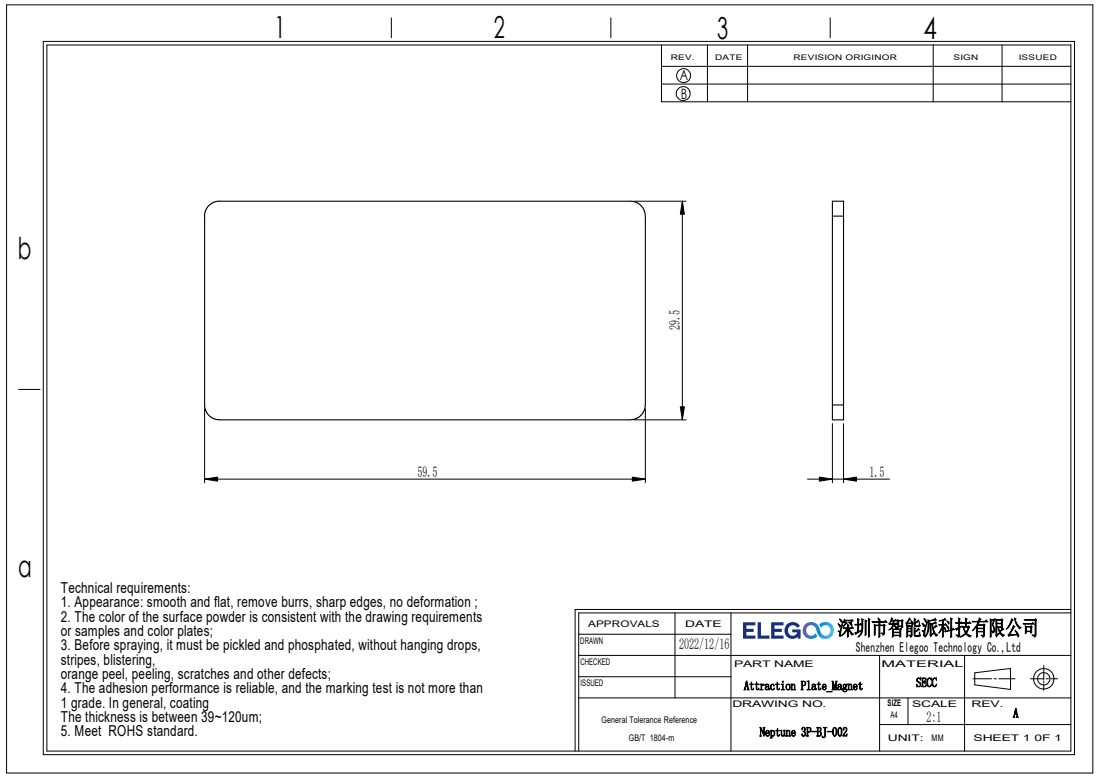
[picture p5: page 1]

REV. | DATE | REVISION ORIGINOR | SIGN | ISSUED

Technical requirements:
1. Appearance: smooth and flat, remove burrs, sharp edges, no deformation ;
2. The color of the surface powder is consistent with the drawing requirements
or samples and color plates;
3. Before spraying, it must be pickled and phosphated, without hanging drops,
stripes, blistering,
orange peel, peeling, scratches and other defects;
4. The adhesion performance is reliable, and the marking test is not more than
1 grade. In general, coating
The thickness is between 39~120um;
5. Meet ROHS standard.

APPROVALS | DATE | 深圳市智能派科技有限公司 Shenzhen Elegoo Technology Co.,Ltd
DRAWN | 2022/12/16
CHECKED | | PART NAME Attraction Plate_Magnet | MATERIAL SECC
ISSUED
General Tolerance Reference GB/T 1804-m | DRAWING NO. Neptune 3P-BJ-002 | SIZE A4 | SCALE 2:1 | REV. A

UNIT: MM | | SHEET 1 0F 1
