elegooofficial/neptune3plus/2D/Bottom Slider Plate.pdf

4

1 | 2 | 3

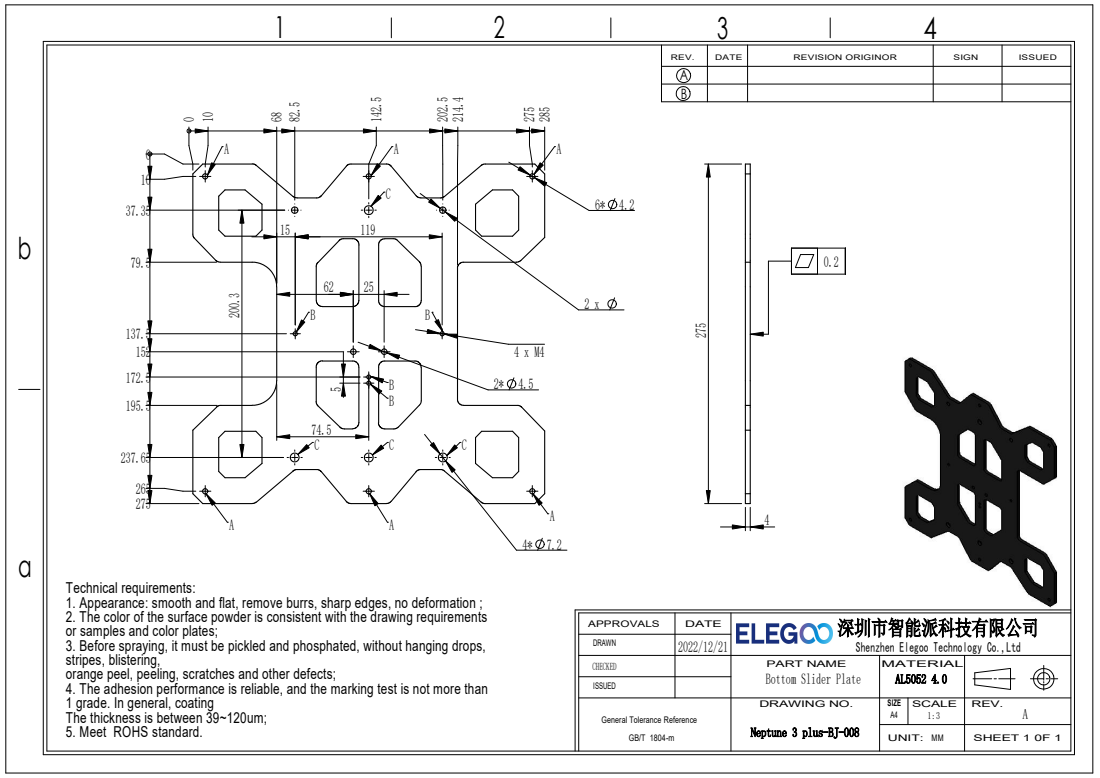
[picture p6: page 1]
5. Meet ROHS standard.; Neptune 3 plus-BJ-008

REV. | DATE | REVISION ORIGINOR | SIGN | ISSUED

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

APPROVALS | DATE | 深圳市智能派科技有限公司 Shenzhen Elegoo Technology Co.,Ltd
DRAWN | 2022/12/21
CHECKED | | PART NAME Bottom Slider Plate | MATERIAL AL5052 4.0
ISSUED
General Tolerance Reference GB/T 1804-m | DRAWING NO. | SIZE A4 | SCALE 1:3 | REV. A

UNIT: MM | | SHEET 1 0F 1
