elegooofficial/neptune3plus/2D/Cover Plate_Top.pdf

4

1 | 2 | 3

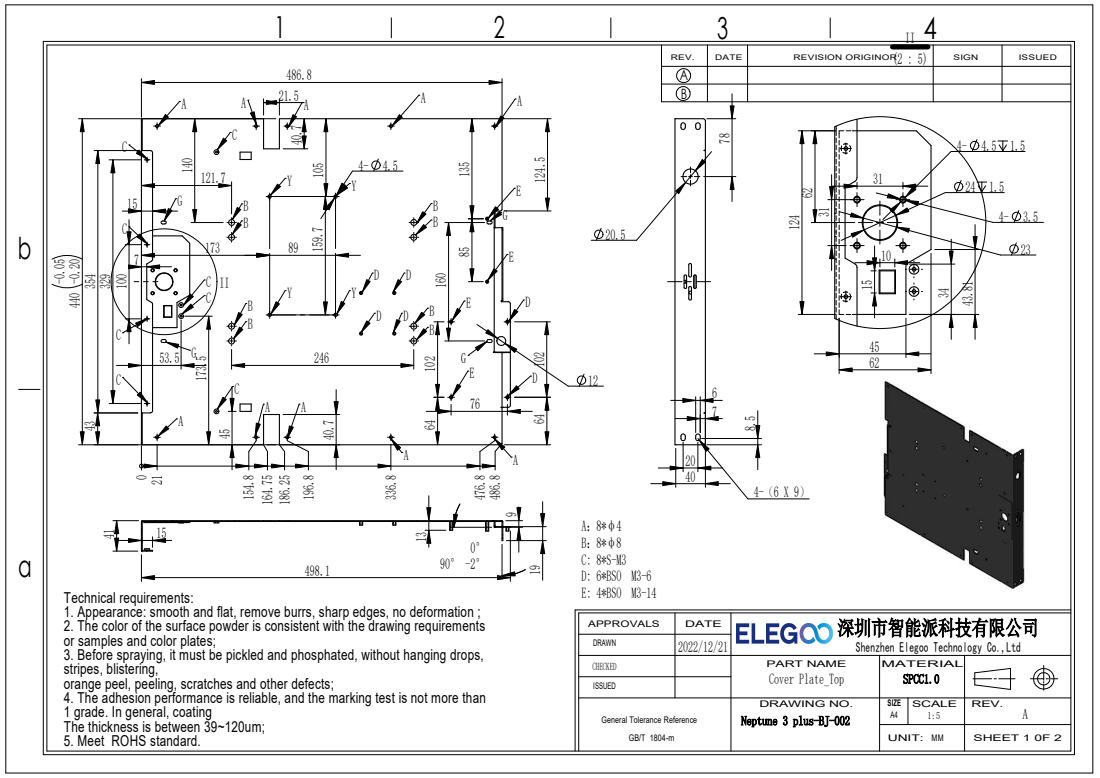
[picture p7: page 1]
A：8*φ4 B：8*φ8 C: 8*S-M3 D: 6*BSO M3-6 E: 4*BSO M3-14

486.8 | REV. | DATE | REVISION ORIGINOR (2 : 5) | SIGN | ISSUED

Technical requirements:
1. Appearance: smooth and flat, remove burrs, sharp edges, no deformation ;
2. The color of the surface powder is consistent with the drawing requirements
or samples and color plates;
3. Before spraying, it must be pickled and phosphated, without hanging drops,
stripes, blistering,
orange peel, peeling, scratches and other defects;
4. The adhesion performance is reliable, and the marking test is not more than
1 grade. In general, coating
The thickness is between 39~120um;
5. Meet ROHS standard.

APPROVALS | DATE | 深圳市智能派科技有限公司 Shenzhen Elegoo Technology Co.,Ltd
DRAWN | 2022/12/21
CHECKED | | PART NAME Cover Plate_Top | MATERIAL SPCC1.0
ISSUED
General Tolerance Reference GB/T 1804-m | DRAWING NO. Neptune 3 plus-BJ-002 | SIZE A4 | SCALE 1:5 | REV. A

UNIT: MM | | SHEET 1 0F 2

4

1 | 2 | 3

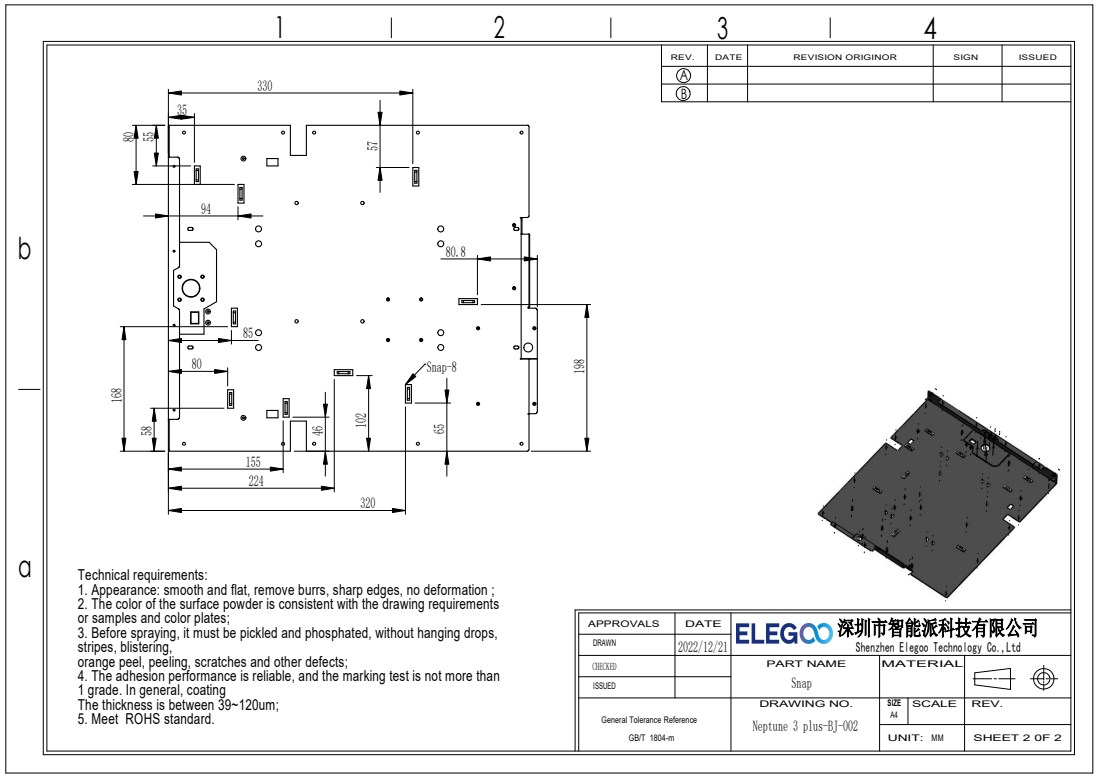
[picture p8: page 2]
Snap-8

330 | REV. | DATE | REVISION ORIGINOR | SIGN | ISSUED

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

APPROVALS | DATE | 深圳市智能派科技有限公司 Shenzhen Elegoo Technology Co.,Ltd
DRAWN | 2022/12/21
CHECKED | | PART NAME Snap | MATERIAL
ISSUED
General Tolerance Reference GB/T 1804-m | DRAWING NO. Neptune 3 plus-BJ-002 | SIZE A4 | SCALE | REV.

UNIT: MM | | SHEET 2 0F 2
