elegooofficial/neptune3plus/2D/Heat Dissipation Block.pdf

4

1 | 2 | 3

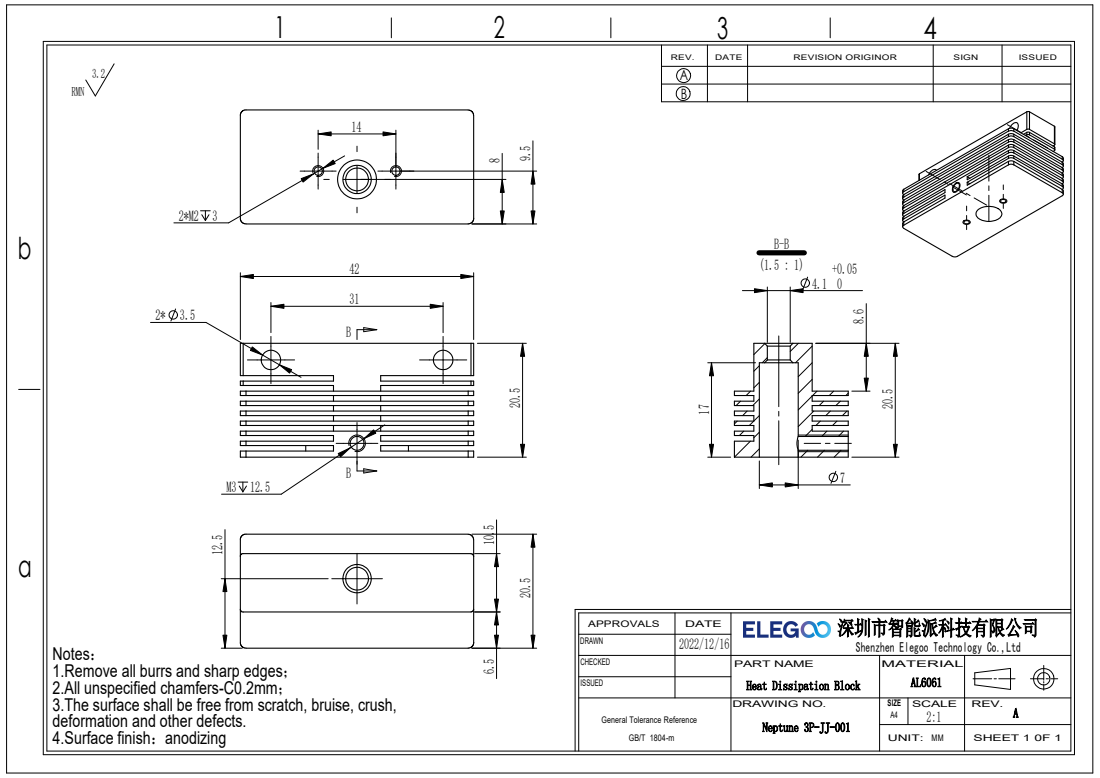
[picture p10: page 1]
RMN

REV. | DATE | REVISION ORIGINOR | SIGN | ISSUED

APPROVALS | DATE | 深圳市智能派科技有限公司 Shenzhen Elegoo Technology Co.,Ltd
DRAWN | 2022/12/16
CHECKED | | PART NAME | MATERIAL AL6061 Heat Dissipation Block
ISSUED
General Tolerance Reference GB/T 1804-m | DRAWING NO. Neptune 3P-JJ-001 | SIZE A4 | SCALE 2:1 | REV. A

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

UNIT: MM | | SHEET 1 0F 1
