elegooofficial/neptune3plus/Wire/Black Silicone Wire.pdf

4

1 | 2 | 3

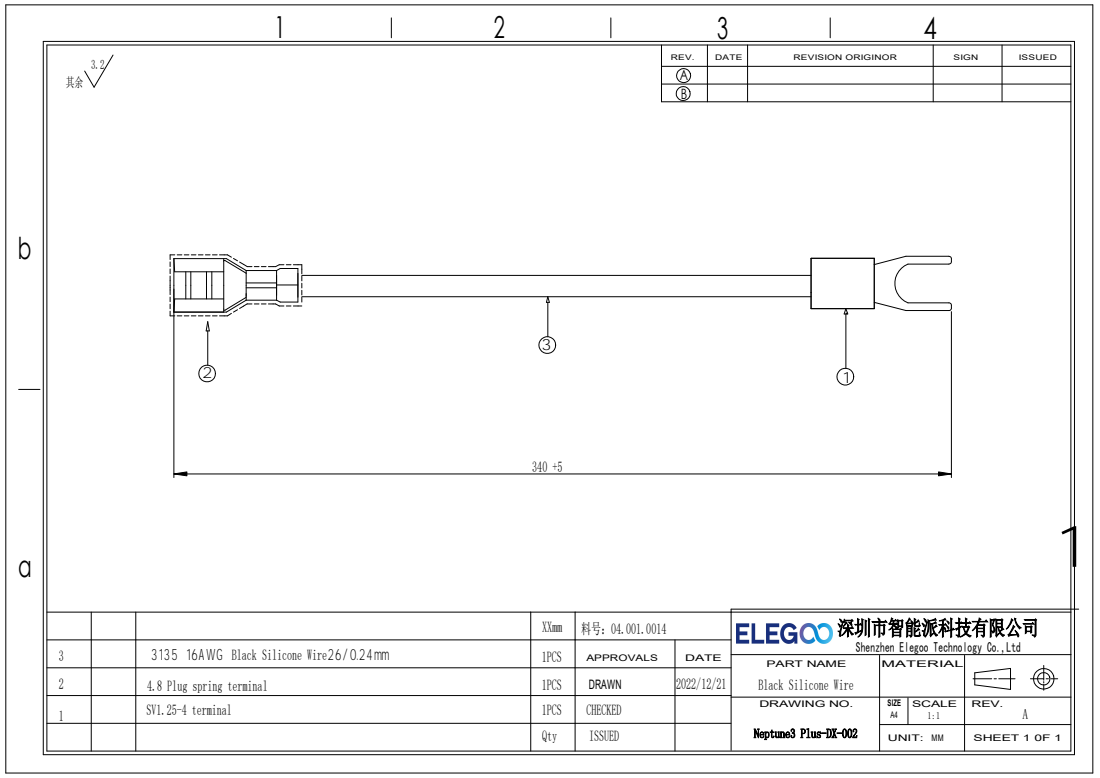
[picture p11: page 1]

REV. | DATE | REVISION ORIGINOR | SIGN | ISSUED

XXmm | 料号：04.001.0014 | 深圳市智能派科技有限公司 Shenzhen Elegoo Technology Co.,Ltd

3 | 3135 16AWG Black Silicone Wire 26/0.24mm | 1PCS | APPROVALS | DATE

PART NAME Black Silicone Wire | MATERIAL

2 | 4.8 Plug spring terminal | 1PCS | DRAWN | 2022/12/21
1 | SV1.25-4 terminal | 1PCS | CHECKED | | DRAWING NO. Neptune3 Plus-DX-002 | SIZE A4 | SCALE 1:1 | REV. A

Qty | ISSUED | | | UNIT: MM | | SHEET 1 0F 1
