elegooofficial/neptune3plus/Wire/Filament Detector Wire.pdf

A
B

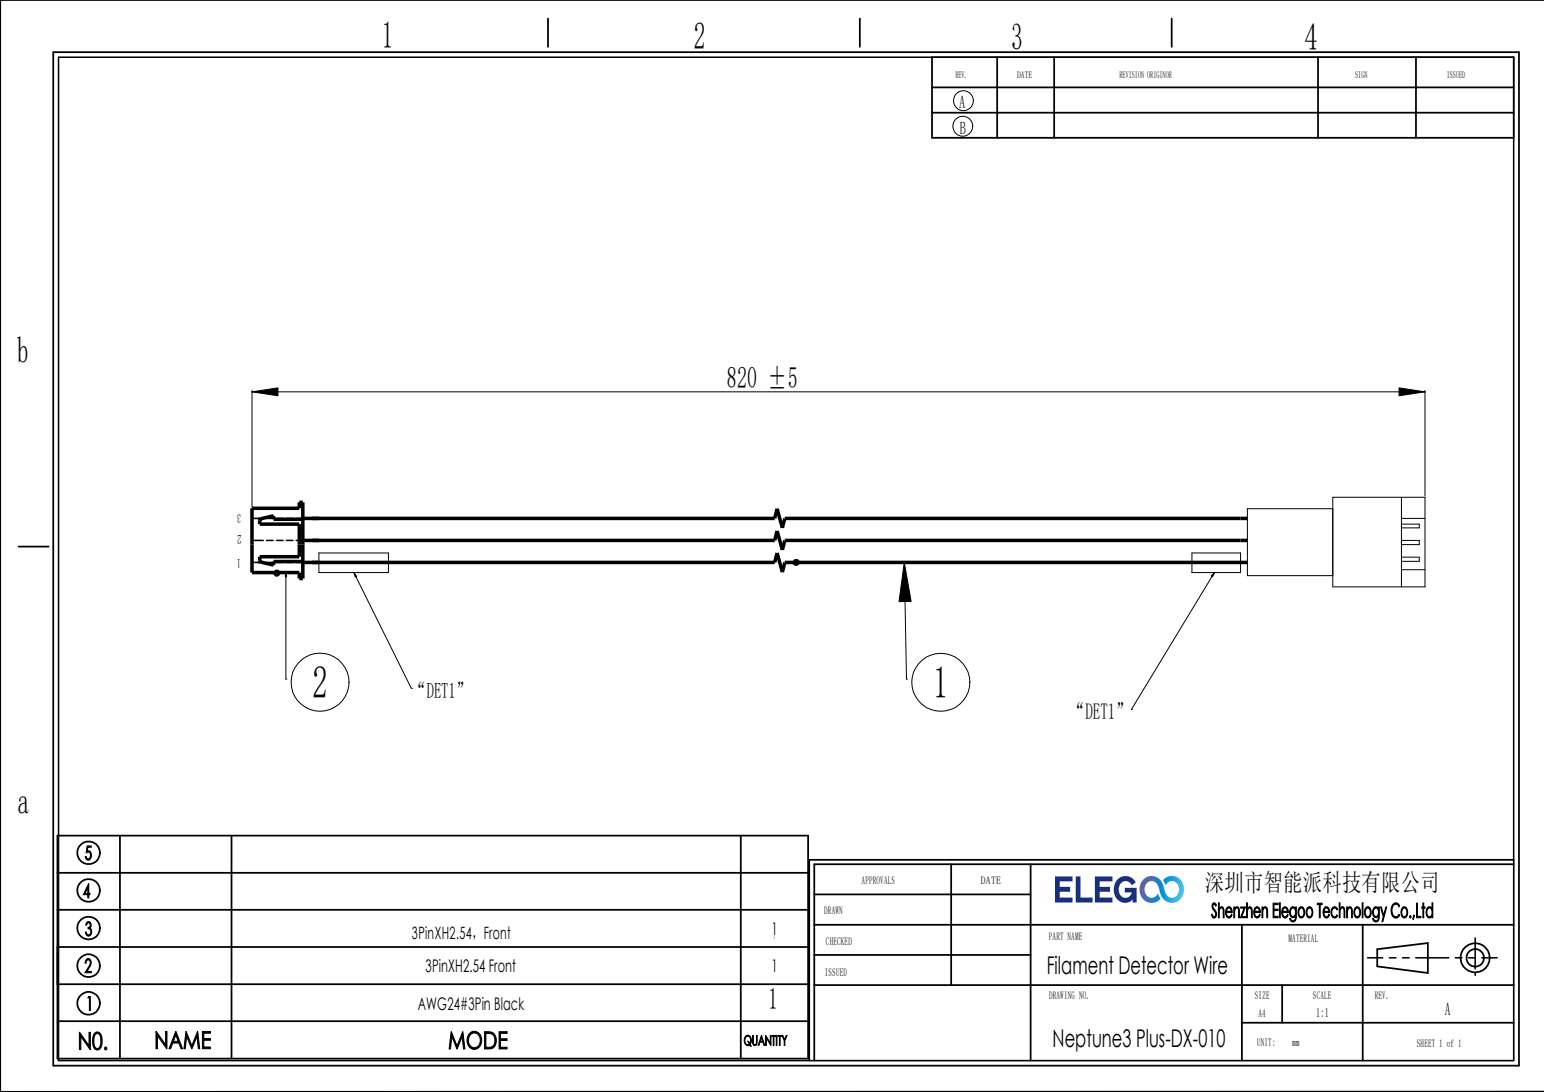
[picture p12: page 1]
“DET1”

REV. | DATE | REVISION ORIGINOR | SIGN | ISSUED

3 | 3PinXH2.54，Front | 1 1
2 | 3PinXH2.54 Front | 1
1 | | AWG24#3Pin Black | 1 | DRAWING NO. Neptune3 Plus-DX-010 | SIZE A4 | SCALE 1:1 | REV. A
N0. | NAME | MODE | QUANTITY | | UNIT: mm | | SHEET 1 of 1

APPROVALS | DATE | 深圳市智能派科技有限公司 Shenzhen Elegoo Technology Co.,Ltd

DRAWN

CHECKED | | PART NAME Filament Detector Wire | MATERIAL

ISSUED
