elegooofficial/neptune3plus/Wire/Ground Wire_Power Supply.pdf

4

1 | 2 | 3

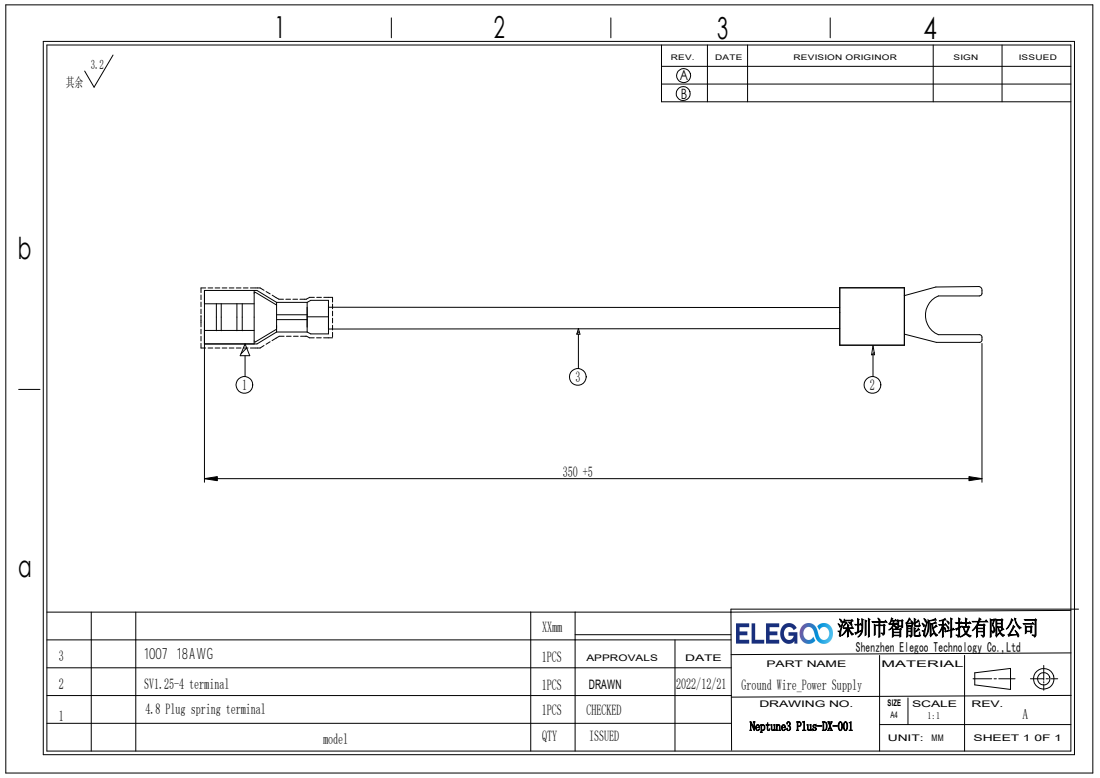
[picture p13: page 1]

REV. | DATE | REVISION ORIGINOR | SIGN | ISSUED

XXmm | | 深圳市智能派科技有限公司 Shenzhen Elegoo Technology Co.,Ltd

3 | 1007 18AWG | 1PCS | APPROVALS | DATE

PART NAME Ground Wire_Power Supply | MATERIAL

2 | SV1.25-4 terminal | 1PCS | DRAWN | 2022/12/21

1 | 4.8 Plug spring terminal | 1PCS | CHECKED | | DRAWING NO. Neptune3 Plus-DX-001 | SIZE A4 | SCALE 1:1 | REV. A

model | QTY | ISSUED | | | UNIT: MM | | SHEET 1 0F 1
