elegooofficial/neptune3plus/Wire/Heated Bed Wire-I.pdf

A
B

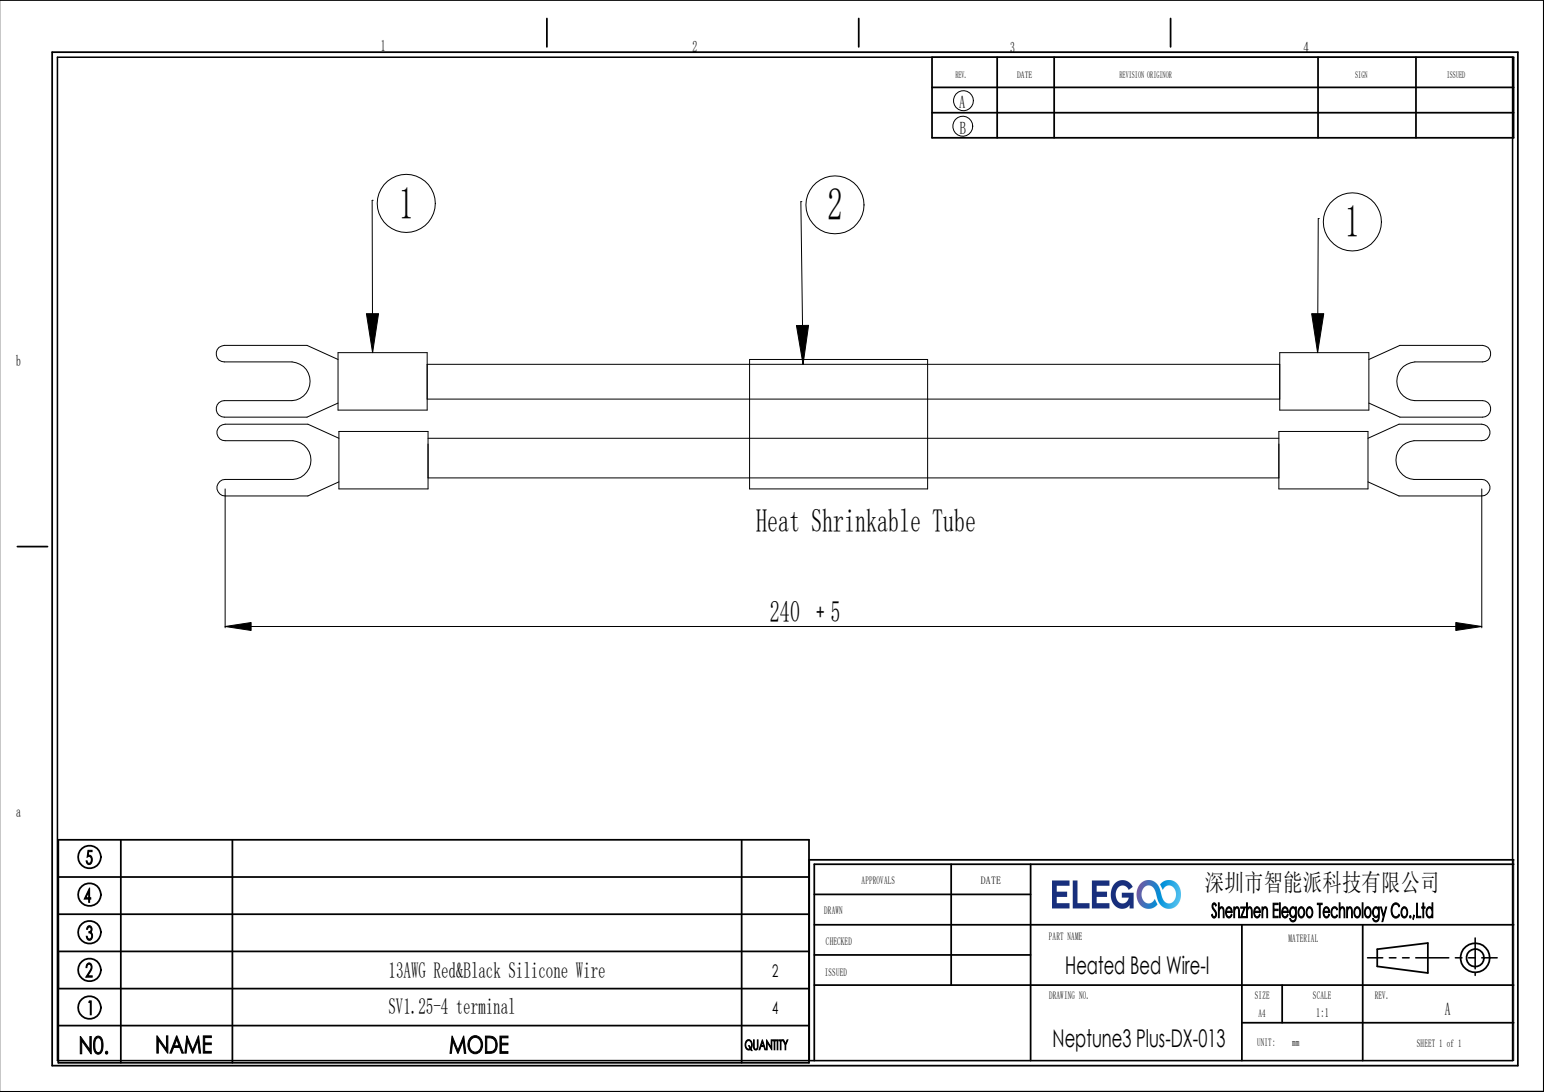
[picture p14: page 1]

REV. | DATE | REVISION ORIGINOR | SIGN | ISSUED

Heat Shrinkable Tube

2 | | 13AWG Red&Black Silicone Wire | 2 | ISSUED
1 | | SV1.25-4 terminal | 4 | | DRAWING NO. Neptune3 Plus-DX-013 | SIZE A4 | SCALE 1:1 | REV. A
N0. | NAME | MODE | QUANTITY | | | UNIT: mm | | SHEET 1 of 1

APPROVALS | DATE | 深圳市智能派科技有限公司 Shenzhen Elegoo Technology Co.,Ltd

DRAWN

CHECKED | | PART NAME Heated Bed Wire-I | MATERIAL
