elegooofficial/neptune3plus/Wire/LED Outgoing wire.pdf

A
B

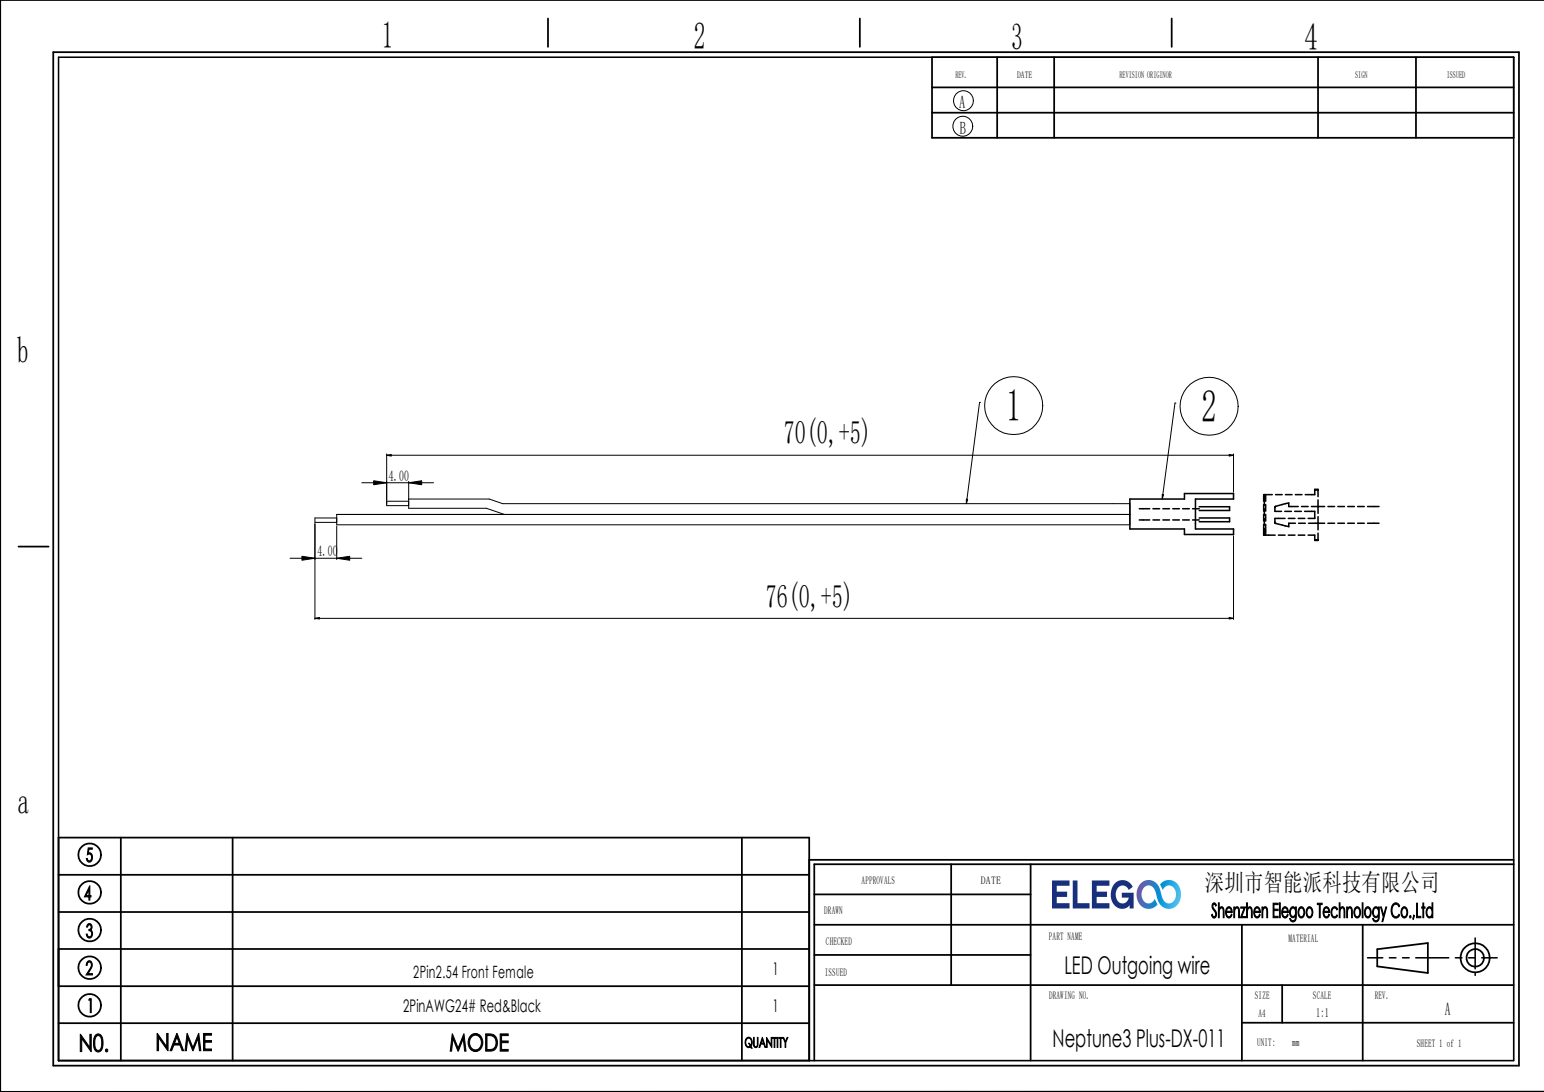
[picture p16: page 1]

REV. | DATE | REVISION ORIGINOR | SIGN | ISSUED

2 | 2Pin2.54 Front Female | 1
1 | | 2PinAWG24# Red&Black | 1 | DRAWING NO. Neptune3 Plus-DX-011 | SIZE A4 | SCALE 1:1 | REV. A
N0. | NAME | MODE | QUANTITY | | UNIT: mm | | SHEET 1 of 1

APPROVALS | DATE | 深圳市智能派科技有限公司 Shenzhen Elegoo Technology Co.,Ltd

DRAWN

CHECKED | | PART NAME LED Outgoing wire | MATERIAL

ISSUED
