elegooofficial/neptune3plus/Wire/LED Wire.pdf

| A
| B

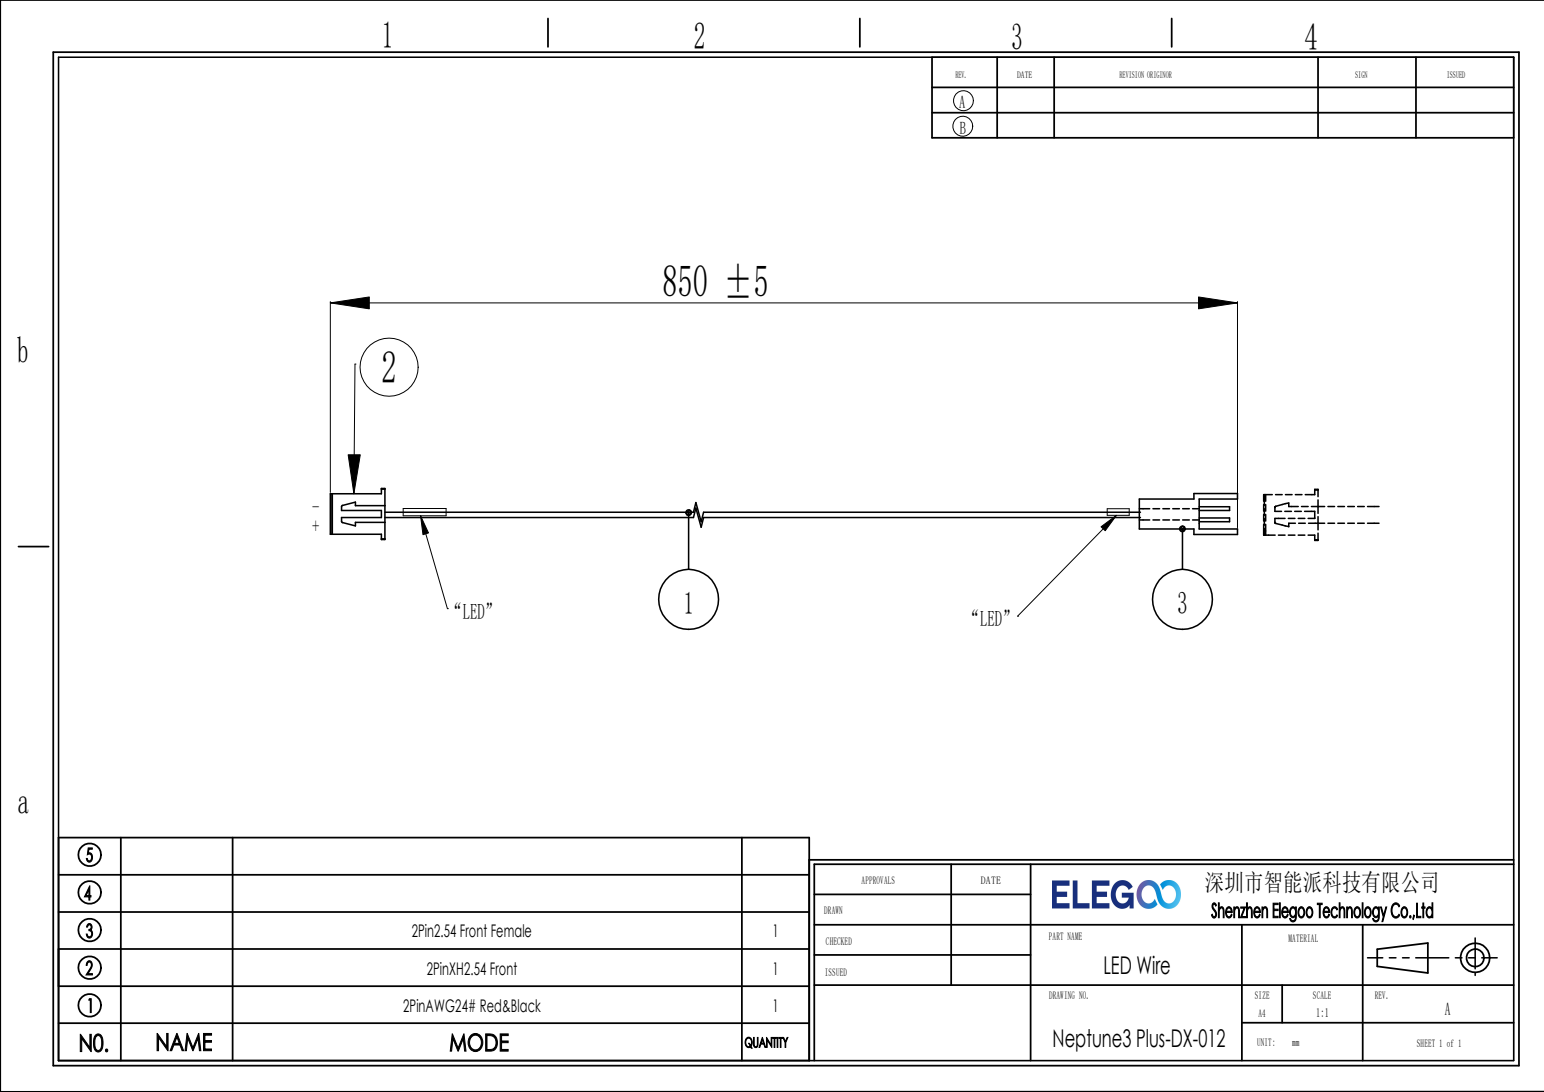
[picture p17: page 1]
“LED”

850 ±5 | REV. | DATE | REVISION ORIGINOR | SIGN | ISSUED

3 | 2Pin2.54 Front Female | 1
2 | 2PinXH2.54 Front | 1
1 | | 2PinAWG24# Red&Black | 1 | DRAWING NO. Neptune3 Plus-DX-012 | SIZE A4 | SCALE 1:1 | REV. A
N0. | NAME | MODE | QUANTITY | | UNIT: mm | | SHEET 1 of 1

APPROVALS | DATE | 深圳市智能派科技有限公司 Shenzhen Elegoo Technology Co.,Ltd

DRAWN

CHECKED | | PART NAME LED Wire | MATERIAL

ISSUED
