elegooofficial/neptune3plus/Wire/Mainboard Wire.pdf

A
B

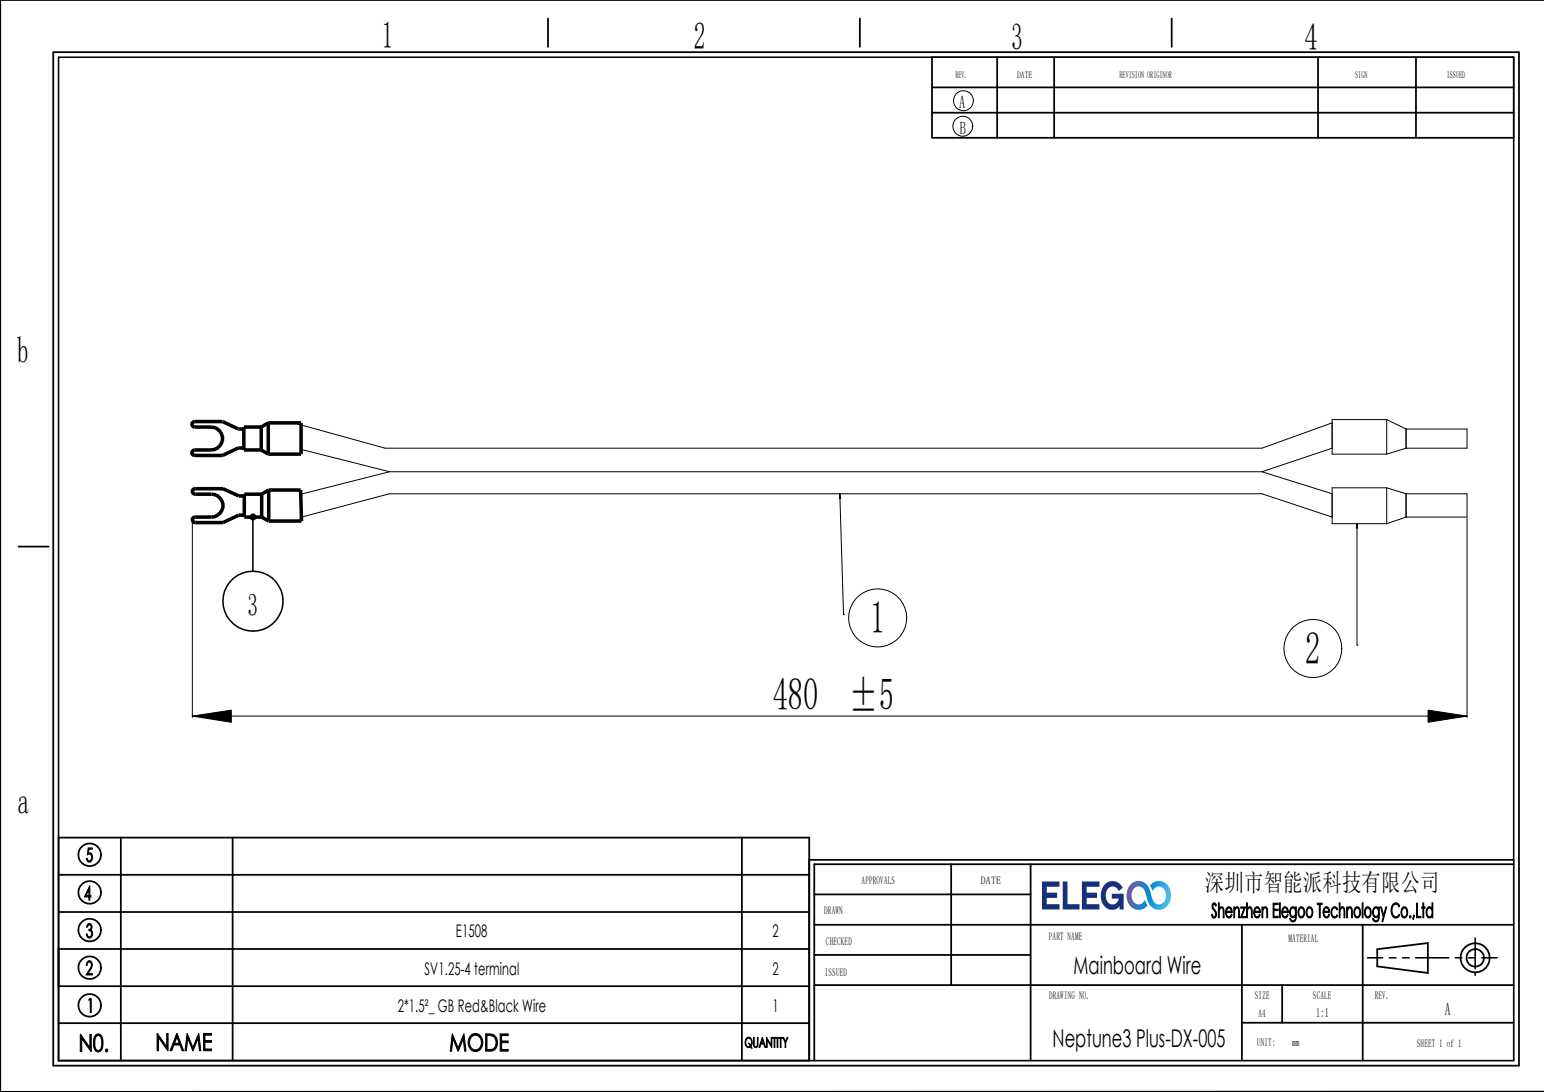
[picture p18: page 1]

REV. | DATE | REVISION ORIGINOR | SIGN | ISSUED

3 | E1508 | 2
2 | SV1.25-4 terminal | 2
1 | | 2*1.5²_ GB Red&Black Wire | 1 | DRAWING NO. Neptune3 Plus-DX-005 | SIZE A4 | SCALE 1:1 | REV. A
N0. | NAME | MODE | QUANTITY | | UNIT: mm | | SHEET 1 of 1

APPROVALS | DATE | 深圳市智能派科技有限公司 Shenzhen Elegoo Technology Co.,Ltd

DRAWN

CHECKED | | PART NAME Mainboard Wire | MATERIAL

ISSUED
