elegooofficial/neptune3plus/Wire/Red Silicone Wire.pdf

4

1 | 2 | 3

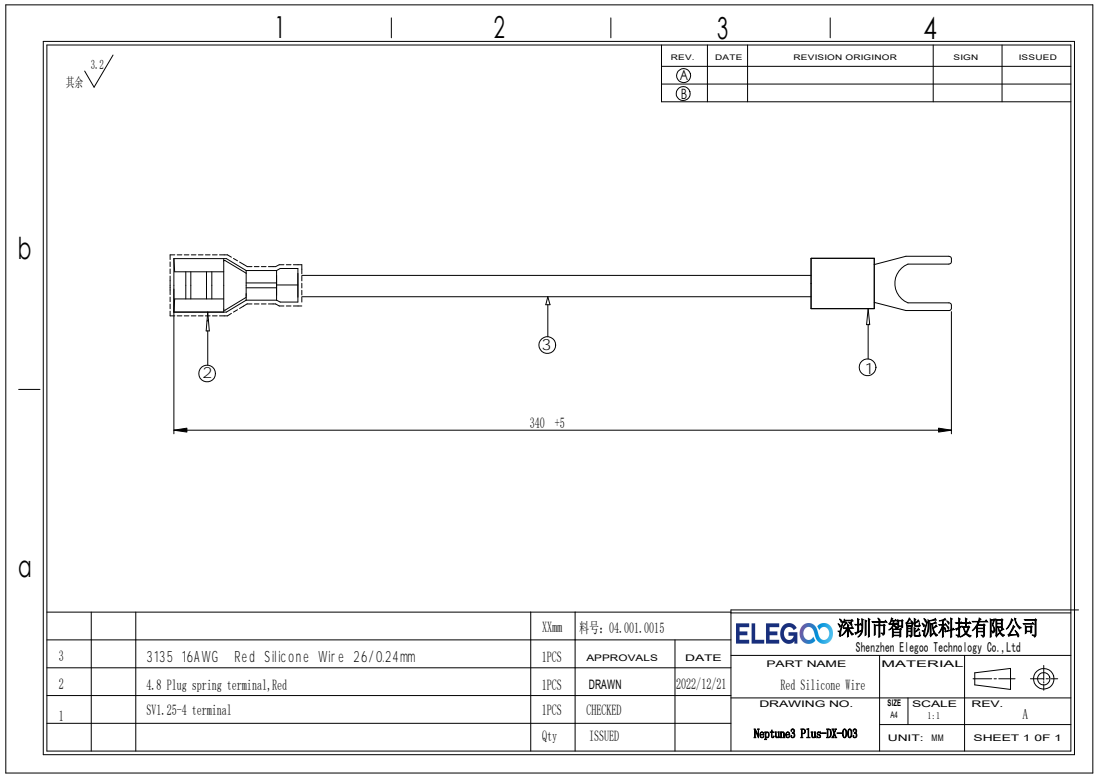
[picture p19: page 1]

REV. | DATE | REVISION ORIGINOR | SIGN | ISSUED

XXmm | 料号：04.001.0015 | 深圳市智能派科技有限公司 Shenzhen Elegoo Technology Co.,Ltd

3 | 3135 16AWG Red Silicone Wire 26/0.24mm | 1PCS | APPROVALS | DATE
2 | 4.8 Plug spring terminal,Red | 1PCS | DRAWN | 2022/12/21
1 | SV1.25-4 terminal | 1PCS | CHECKED | | DRAWING NO. Neptune3 Plus-DX-003 | SIZE A4 | SCALE 1:1 | REV. A

PART NAME Red Silicone Wire | MATERIAL

Qty | ISSUED | | | UNIT: MM | | SHEET 1 0F 1
