elegooofficial/neptune3plus/Wire/Signal Wire_Heated Bed.pdf

A
B

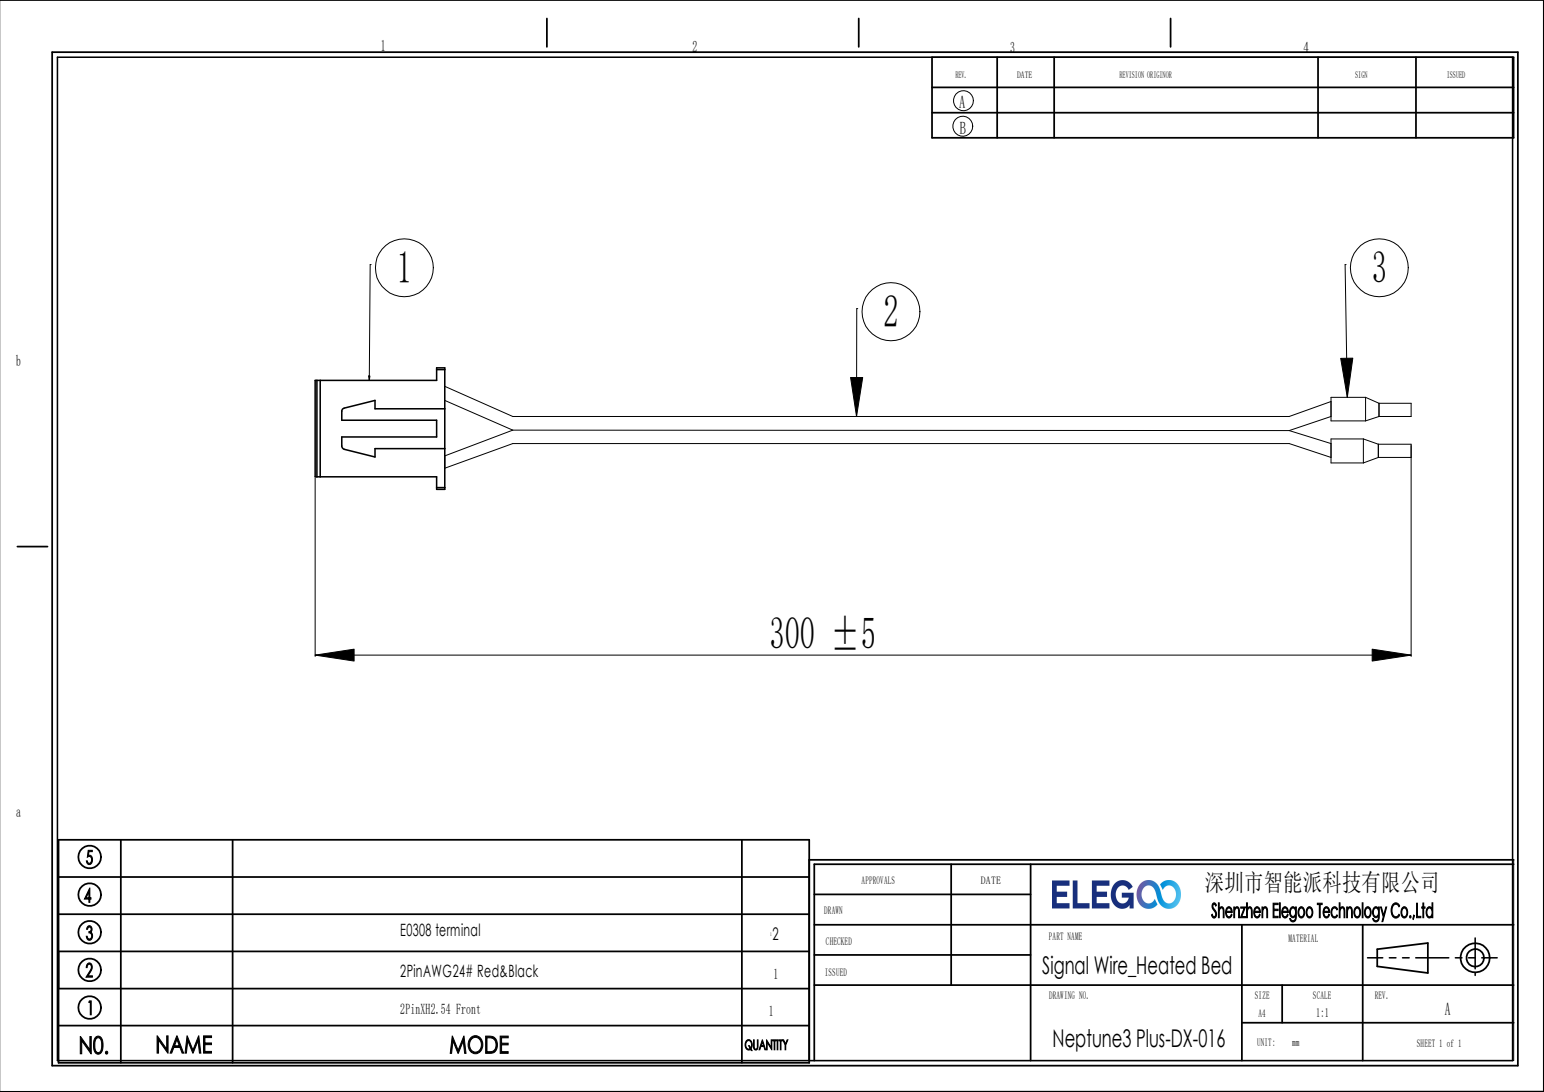
[picture p20: page 1]

REV. | DATE | REVISION ORIGINOR | SIGN | ISSUED

3 | E0308 terminal | 2 1
2 | | 2PinAWG24# Red&Black | 1 | ISSUED
1 | | 2PinXH2.54 Front | 1 | | DRAWING NO. Neptune3 Plus-DX-016 | SIZE A4 | SCALE 1:1 | REV. A
N0. | NAME | MODE | QUANTITY | | | UNIT: mm | | SHEET 1 of 1

APPROVALS | DATE | 深圳市智能派科技有限公司 Shenzhen Elegoo Technology Co.,Ltd

DRAWN

CHECKED | | PART NAME Signal Wire_Heated Bed | MATERIAL
