elegooofficial/neptune3plus/Wire/Stepper and limit switch wire_X-axis.pdf

A
B

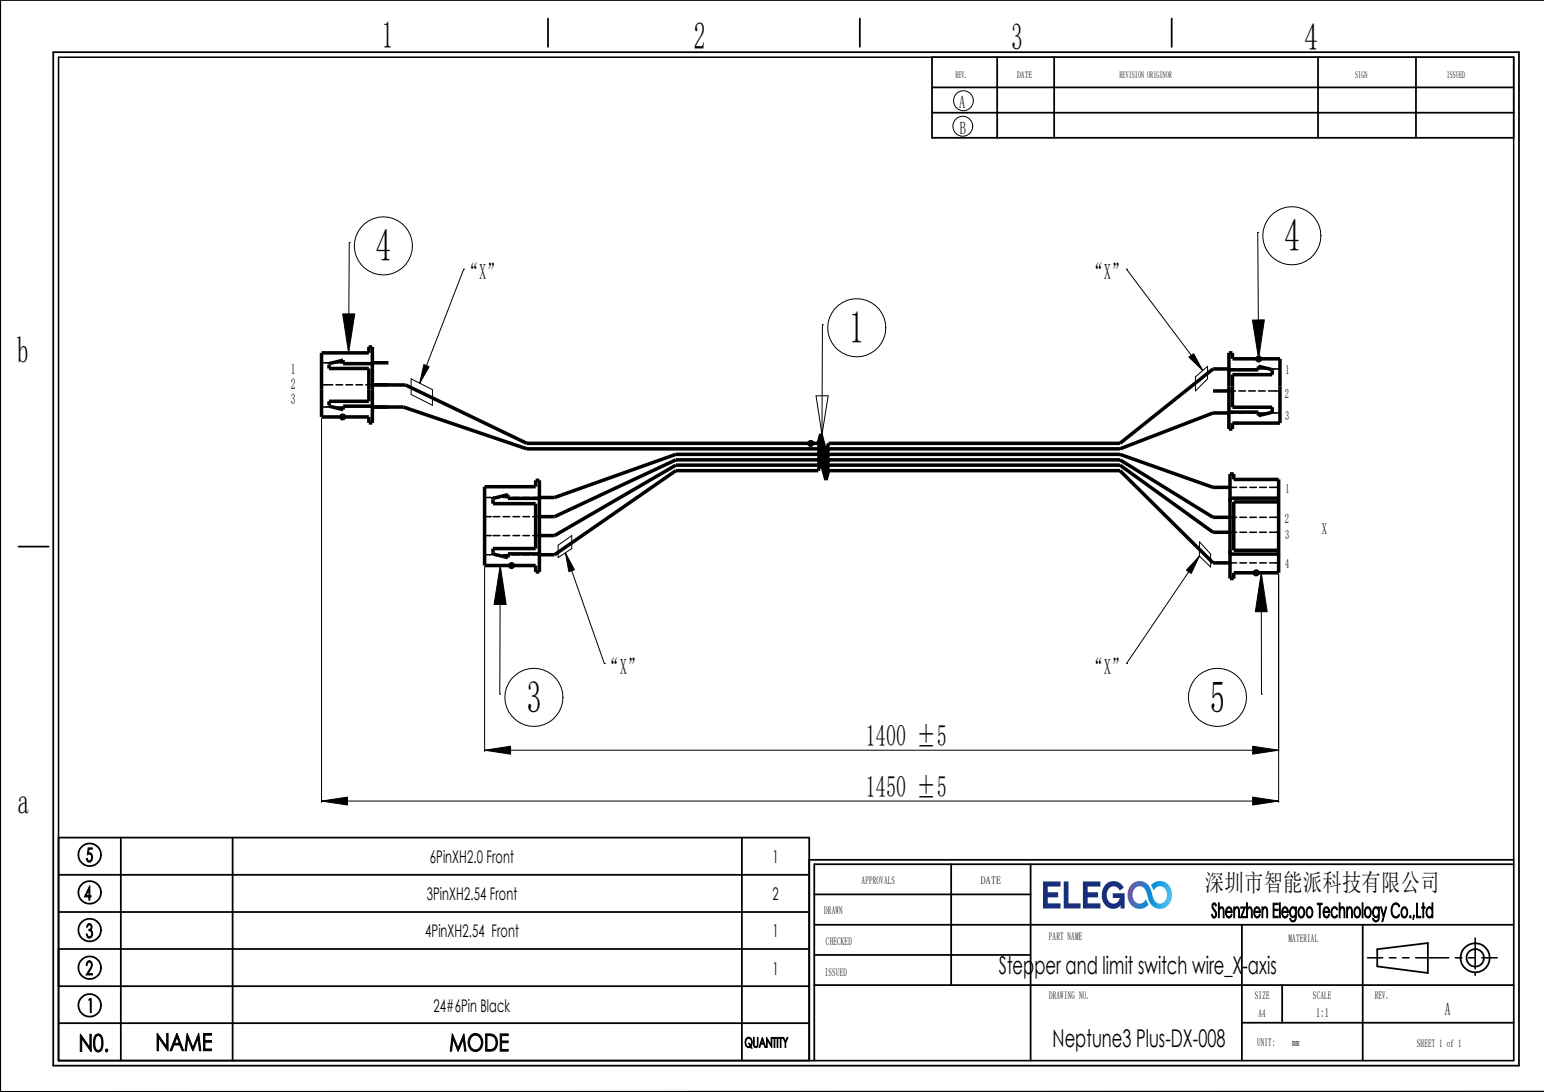
[picture p21: page 1]

REV. | DATE | REVISION ORIGINOR | SIGN | ISSUED

5 | 6PinXH2.0 Front | 1
4 | 3PinXH2.54 Front | 2
3 | 4PinXH2.54 Front | 1
1 | | 24#6Pin Black | | DRAWING NO. Neptune3 Plus-DX-008 | SIZE A4 | SCALE 1:1 | REV. A
N0. | NAME | MODE | QUANTITY | | UNIT: mm | | SHEET 1 of 1

APPROVALS | DATE | 深圳市智能派科技有限公司 Shenzhen Elegoo Technology Co.,Ltd

DRAWN

CHECKED | Stepper and limit switch wire_X-axis | PART NAME | MATERIAL

ISSUED
