elegooofficial/neptune3plus/Wire/Stepper wire_Z-axis.pdf

5

| A

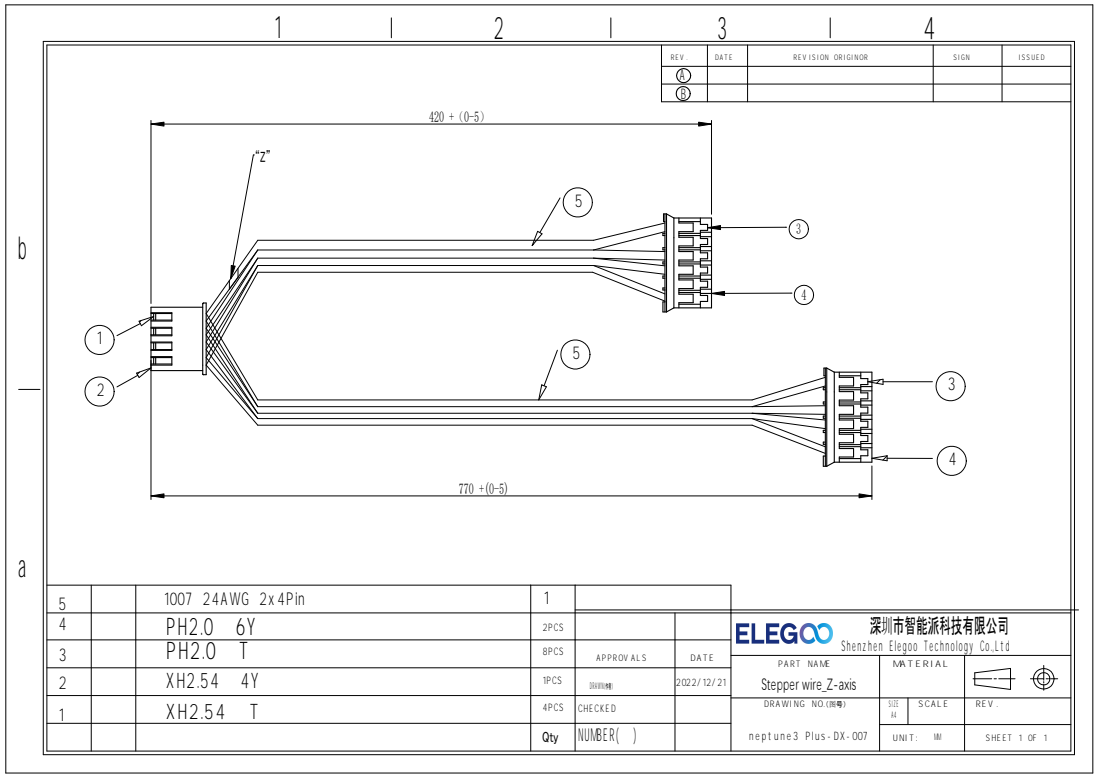
[picture p23: page 1]

420 +（0-5） | REV. | DATE | REVISION ORIGINOR | SIGN | ISSUED

5 | 1007 24AWG 2x4Pin | 1
4 | PH2.0 6Y | 2PCS | | | 深 圳 市智能派科技有限公司 Shenzhen Elegoo Technology Co.,Ltd

3 | PH2.0 T | 8PCS | APPROVALS | DATE

PART NAME Stepper wire_Z-axis | MATERIAL

2 | XH2.54 4Y | 1PCS | DRAWN （作者） | 2022/12/21

1 | XH2.54 T | 4PCS | CHECKED | | DRAWING NO.（ 图号） neptune3 Plus-DX-007 | SIZE A4 | SCALE | REV.

Qty | NUMBER( ) | | | UNIT: MM | | SHEET 1 0F 1
