elegooofficial/neptune3plus/Wire/Filament Detector and LED Wire.pdf

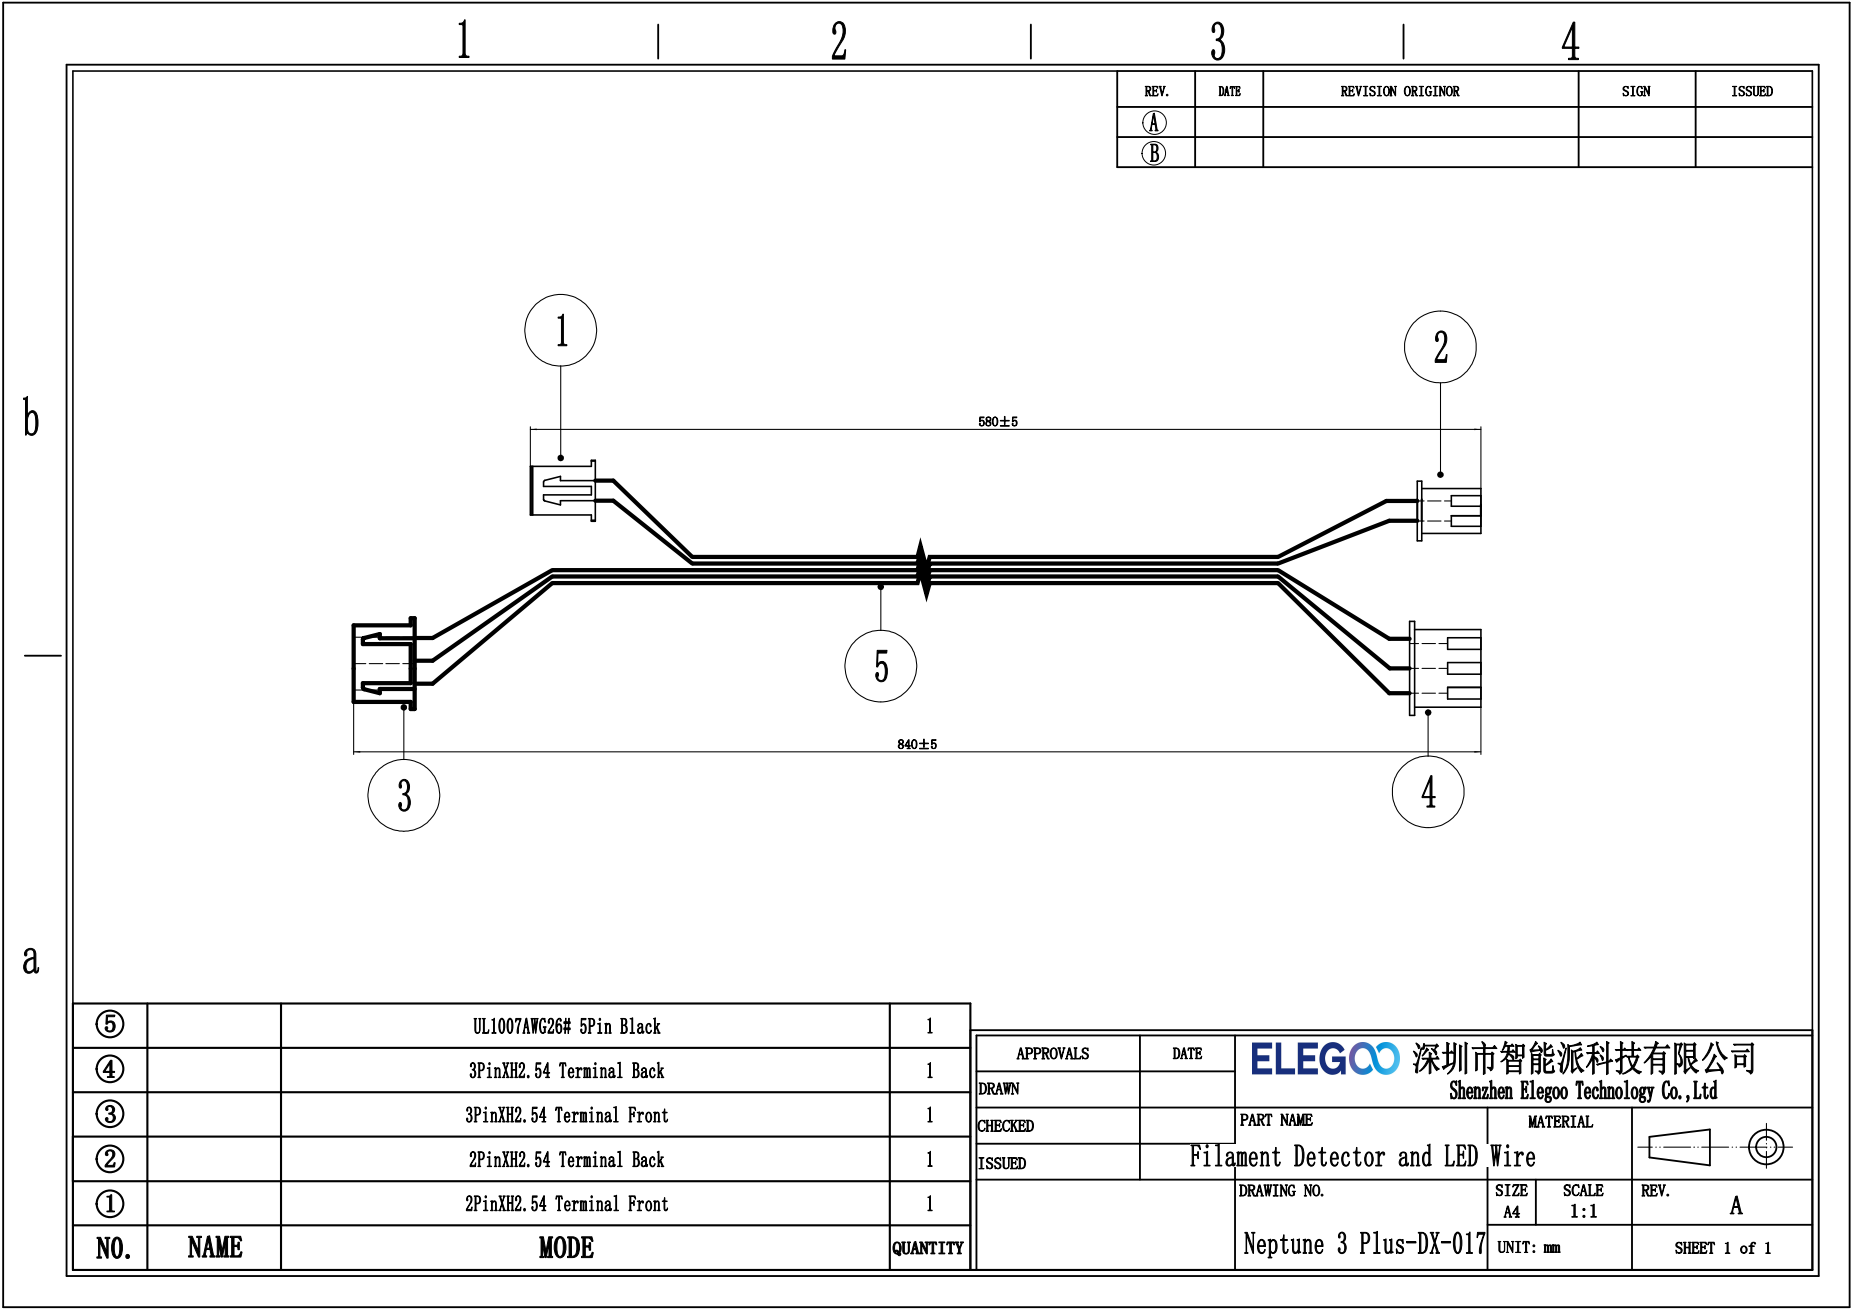
[picture p24: page 1]
